aewallin/ADA4898_LNA/noise_calc/README.md

# ADA4898 LNA Noise

Low Noise Amplifier based on [ADA4898](https://www.analog.com/en/products/ada4898-1.html).
Inspired by Gerhard Hoffmann's "lono" design  http://www.hoffmann-hochfrequenz.de/downloads/lono.pdf

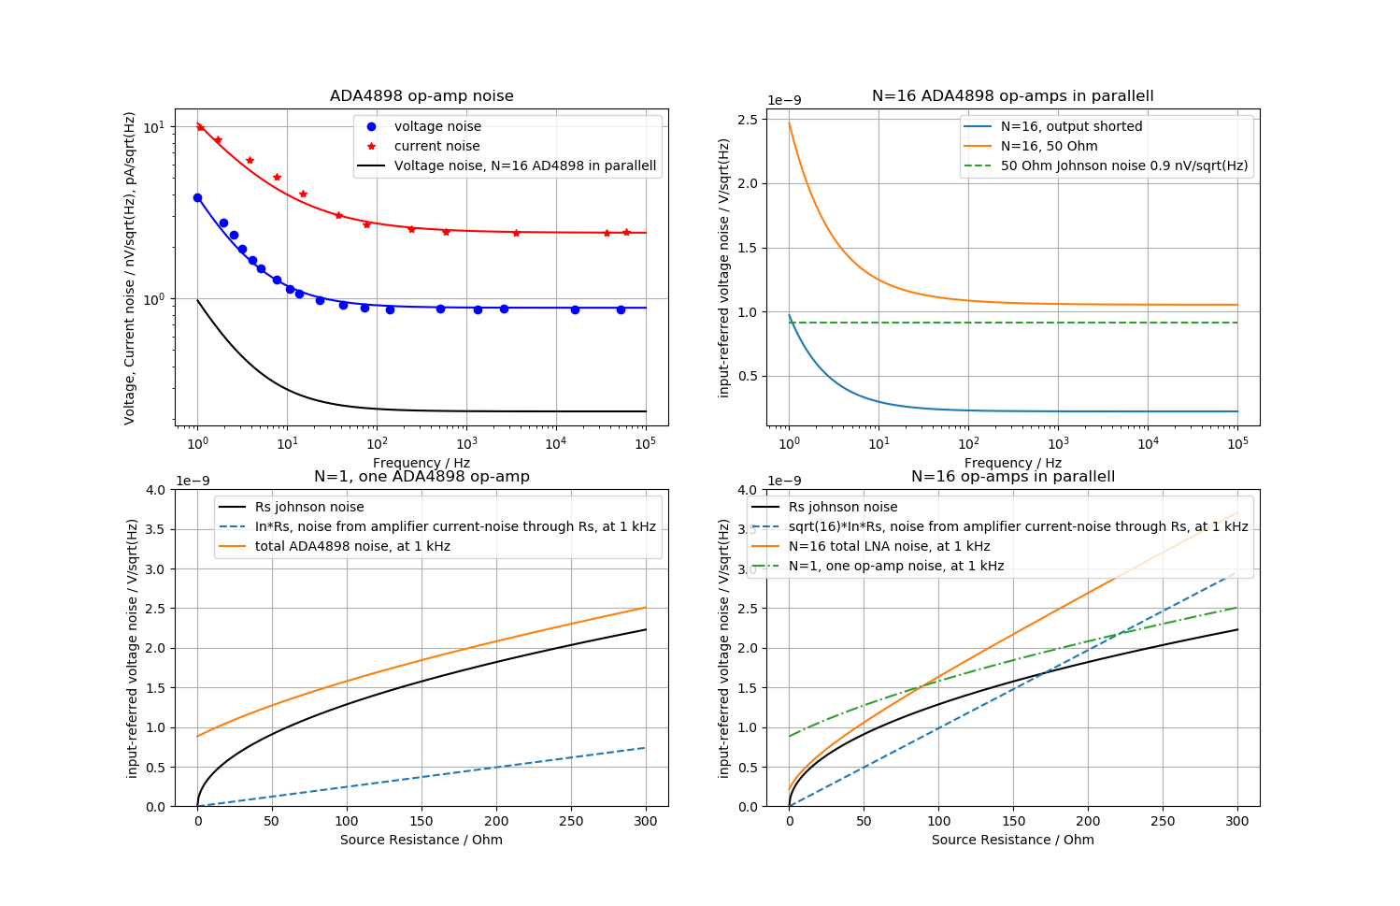
[picture p3: noise_calc/ADA4898_noise.png]
Noise noise
