aewallin/ADA4898_LNA/doc/ADA4898_LNA_schematic.pdf

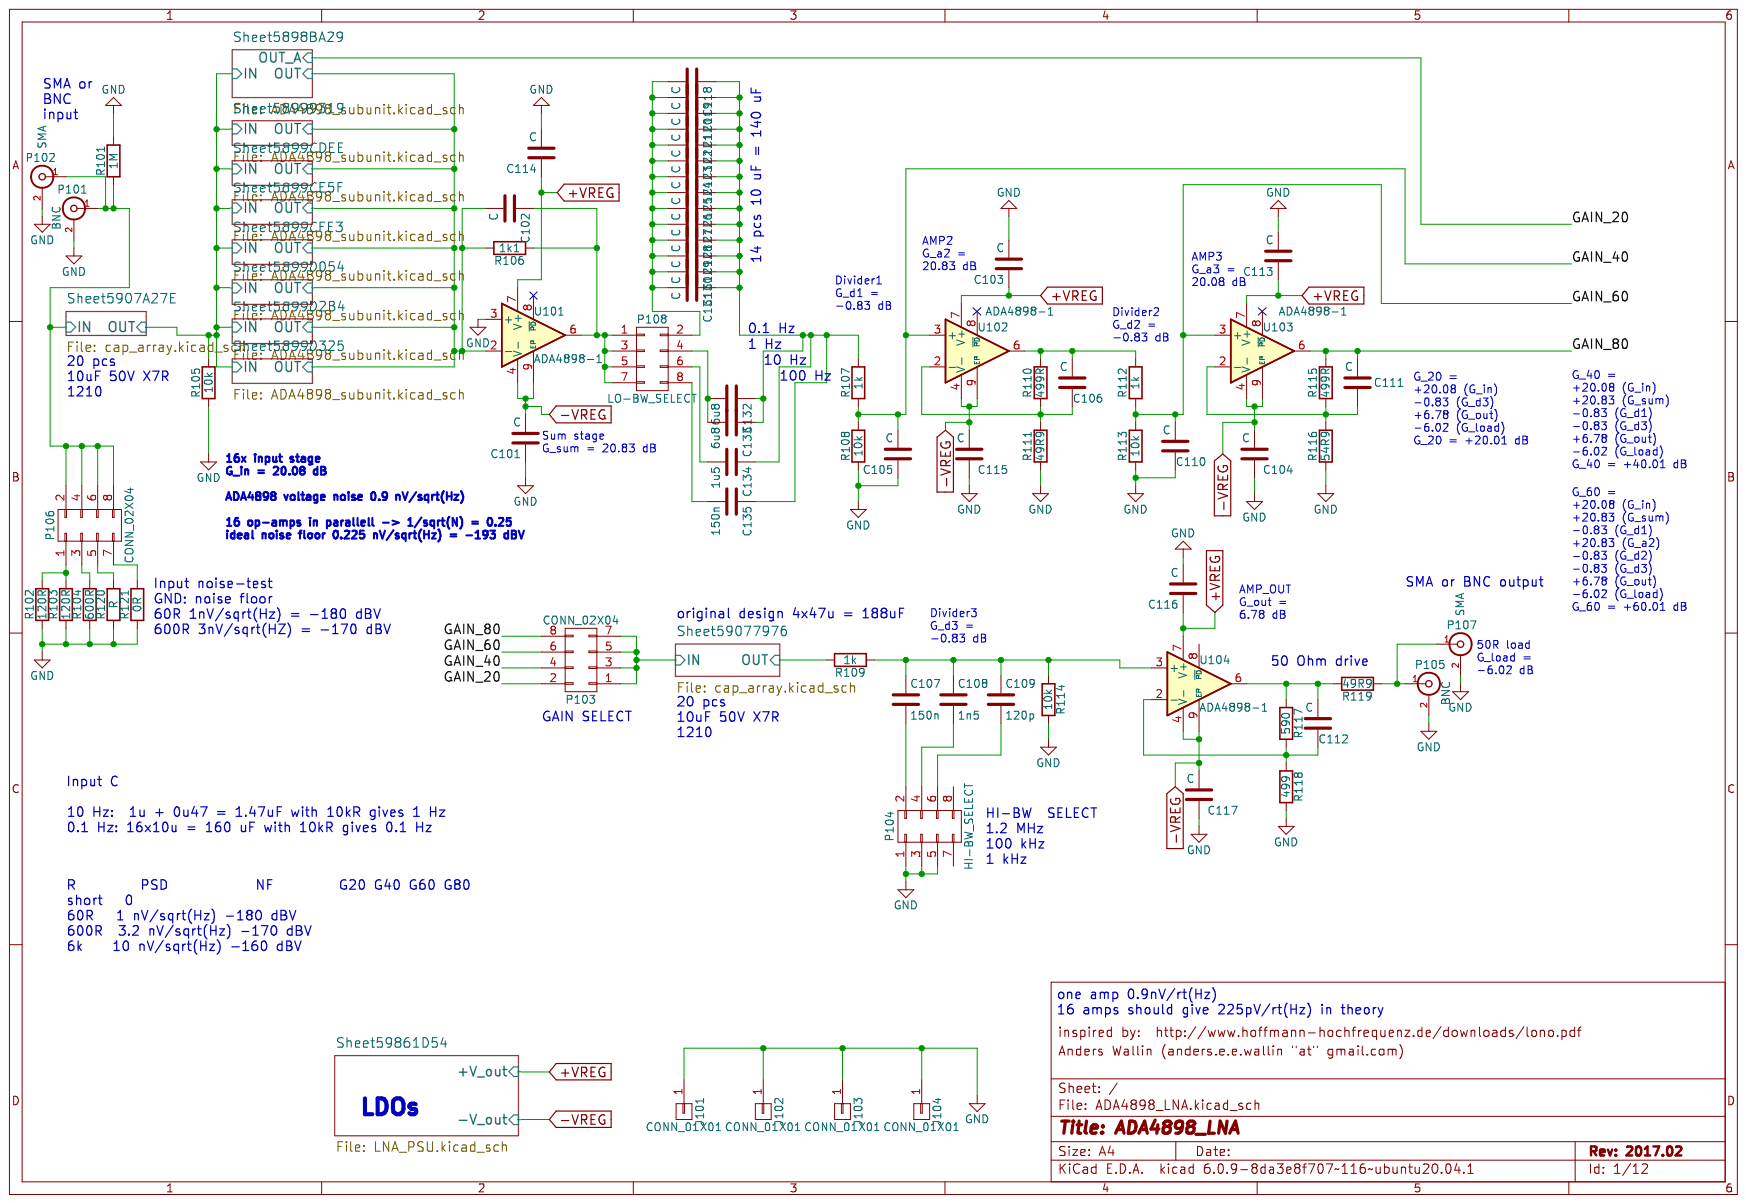
[picture p4: page 1]

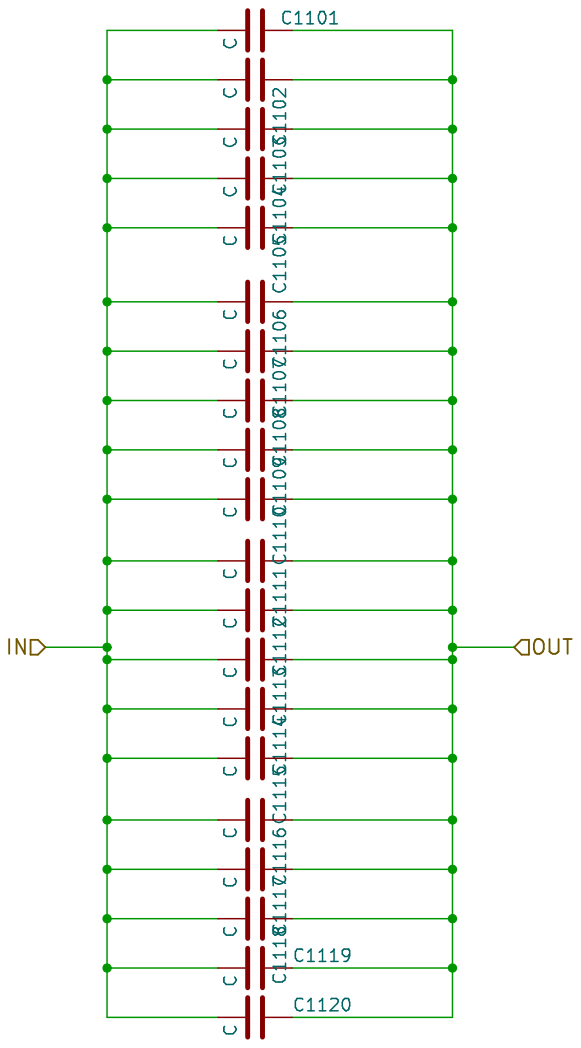
[picture p5: page 2]

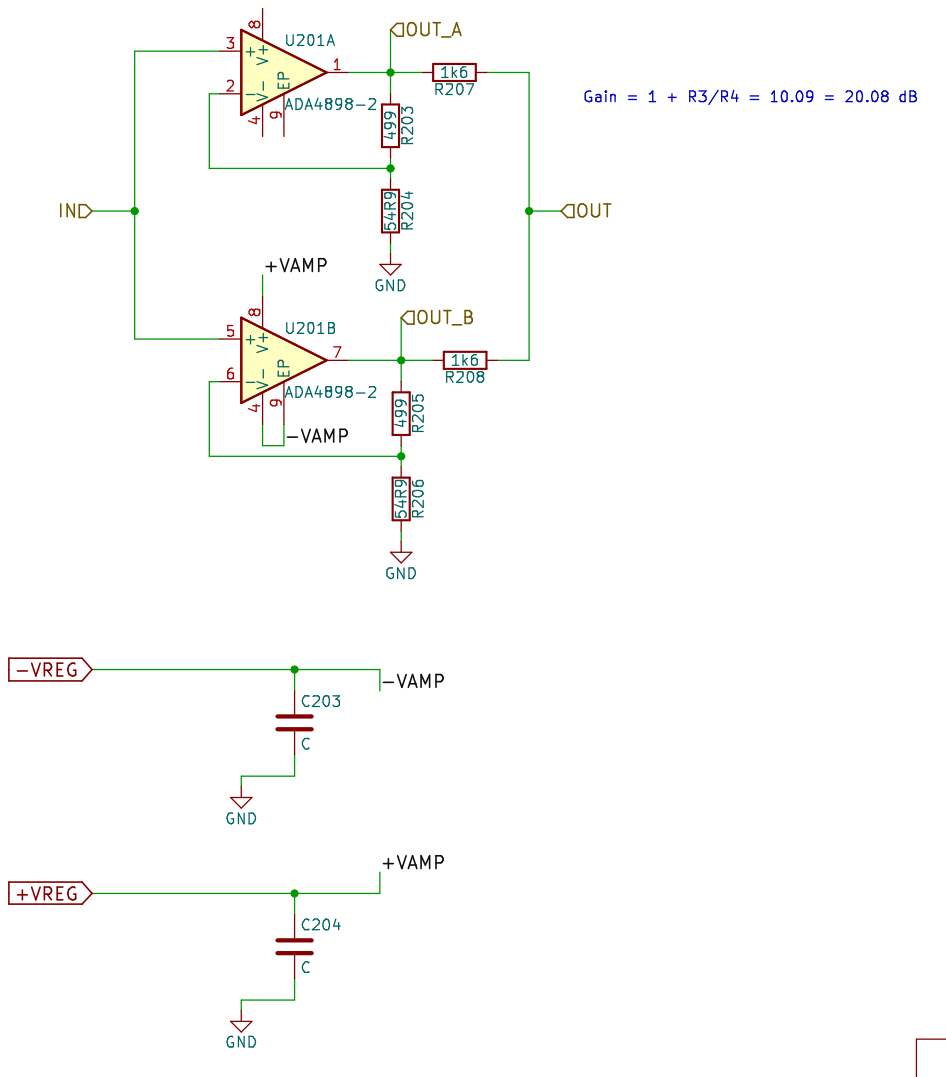
[picture p6: page 3]

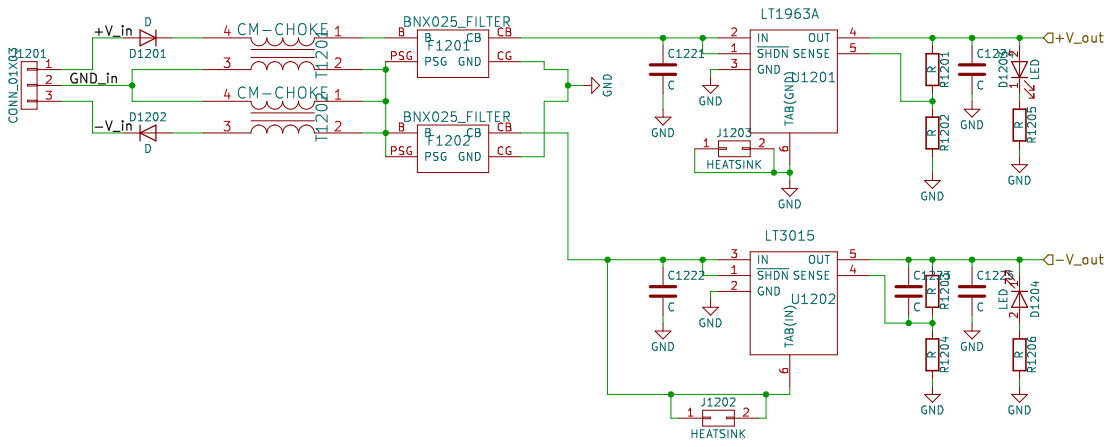
[picture p7: page 11]

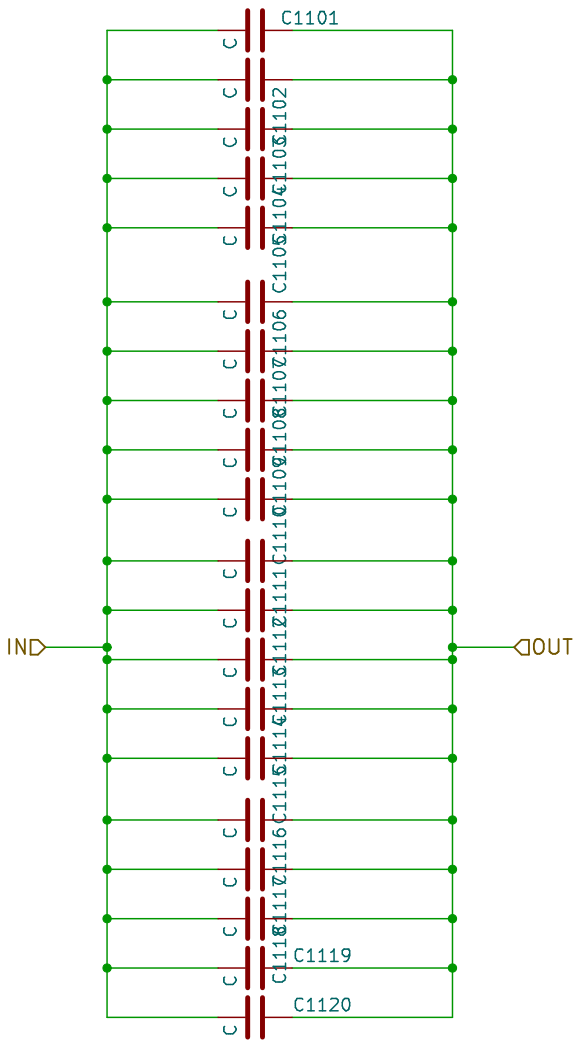
[picture p8: page 12]
