aewallin/ADA4898_LNA/doc/ADA4898_LNA_pcb.pdf

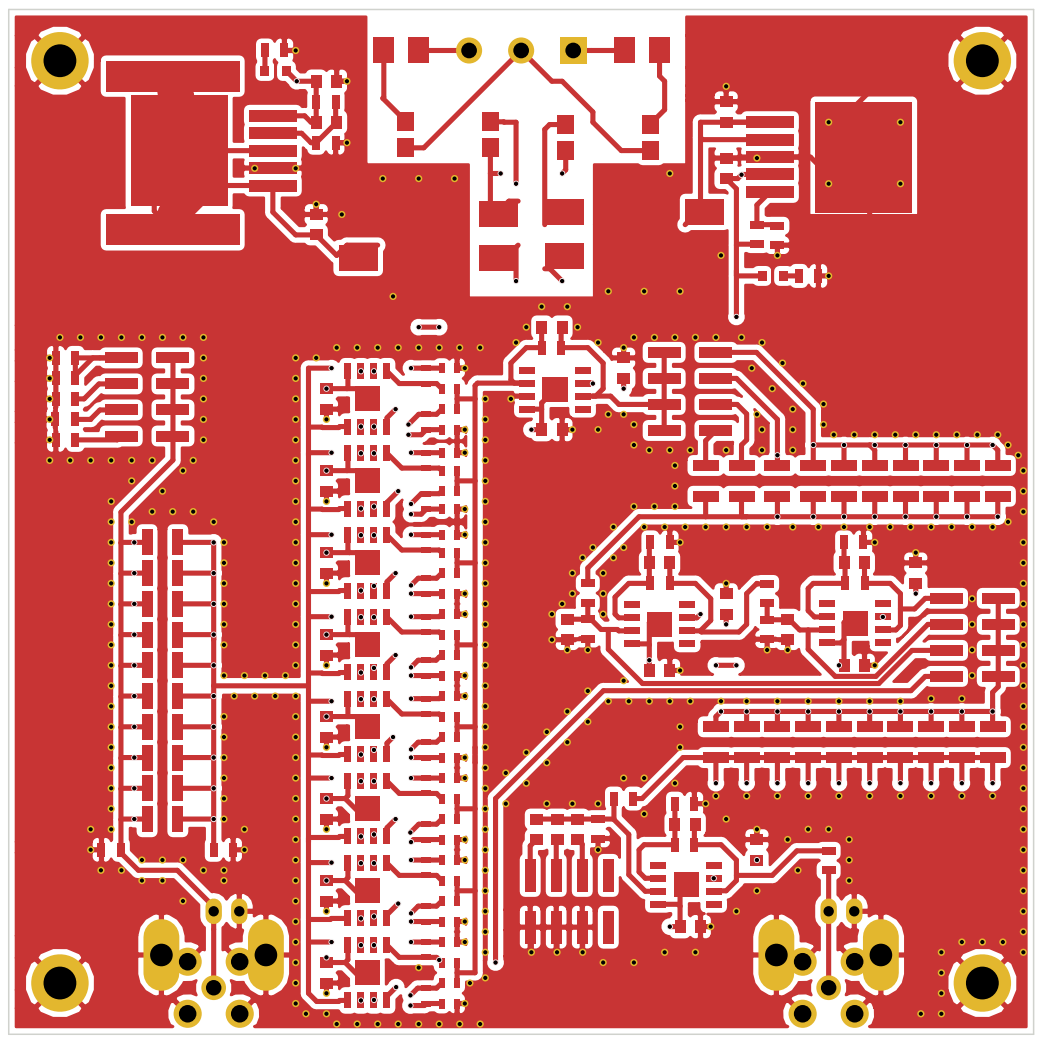
[picture p9: page 1]

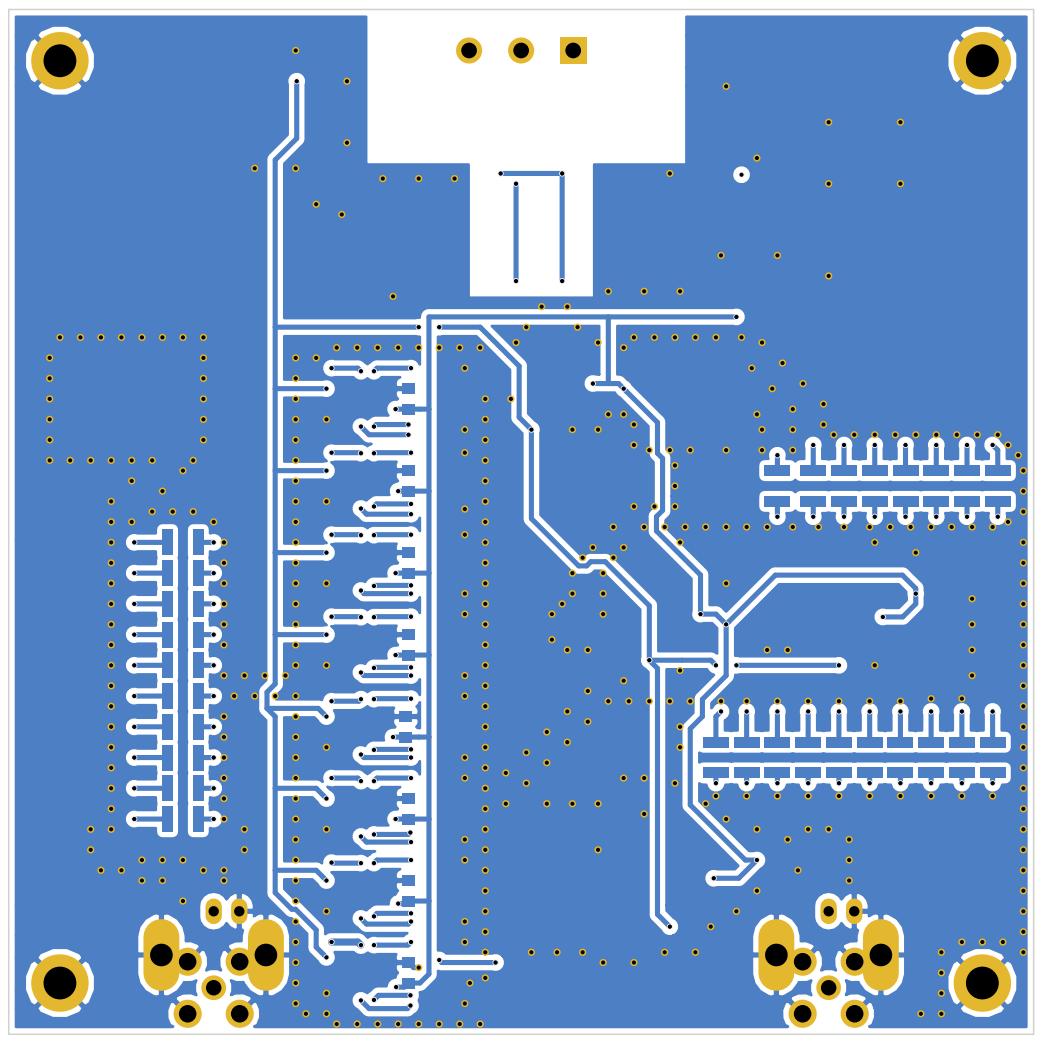
[picture p10: page 2]

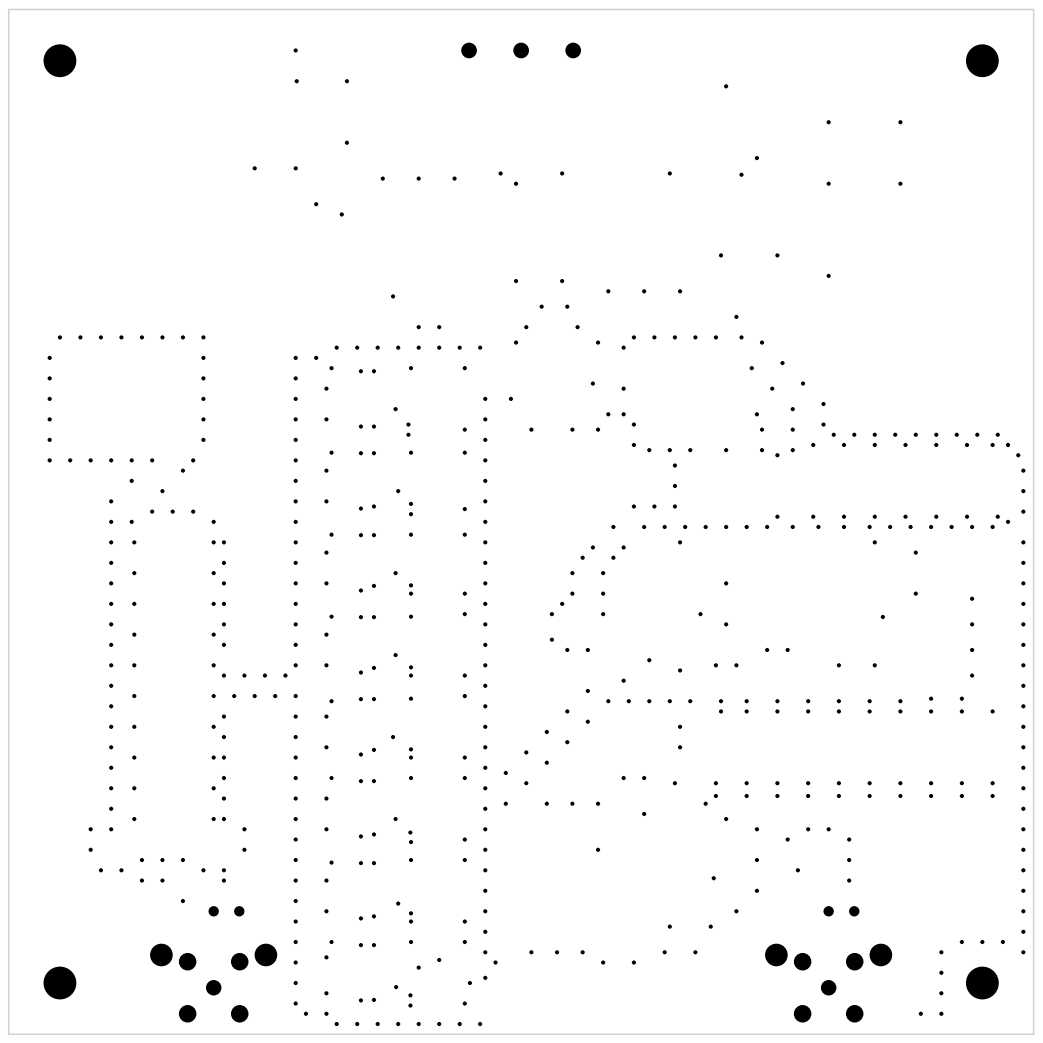
[picture p11: page 3]

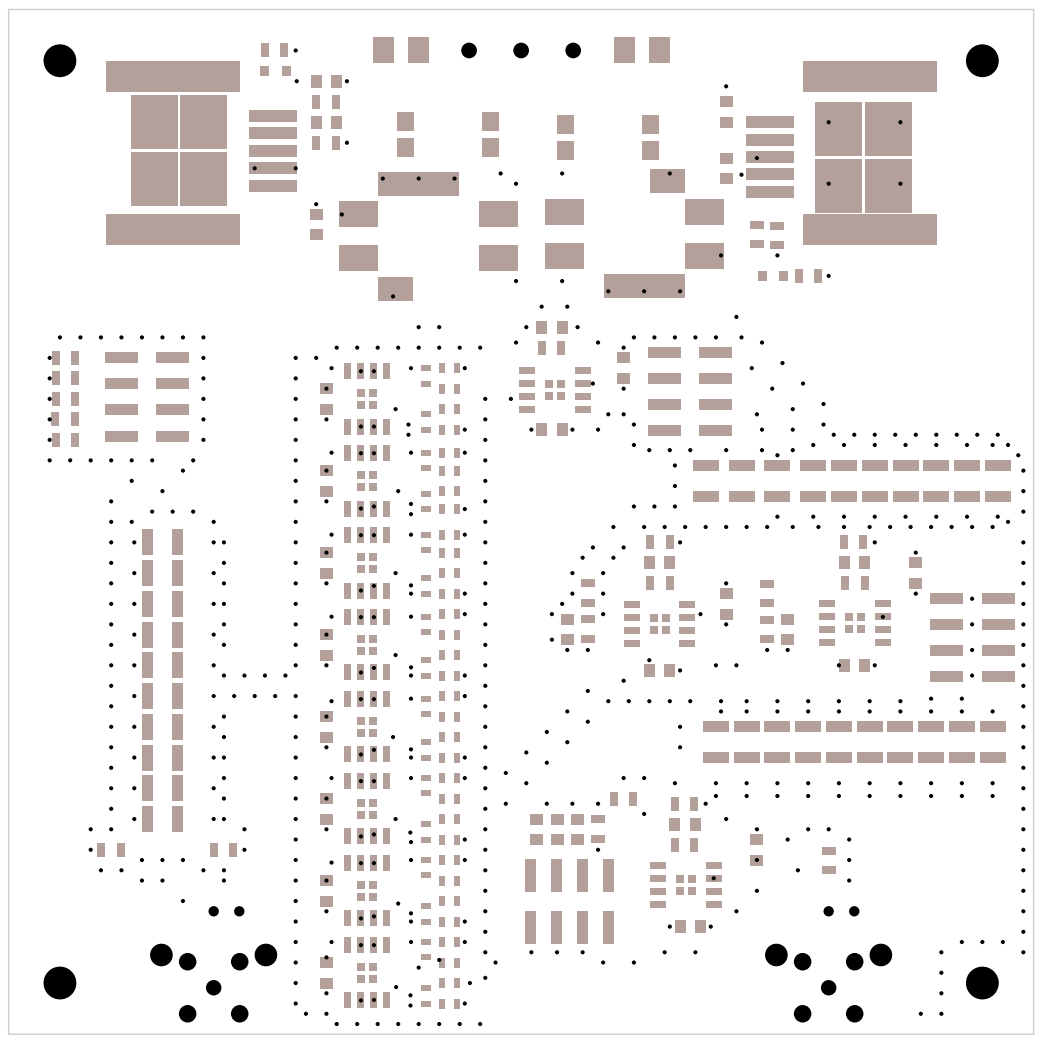
[picture p12: page 5]

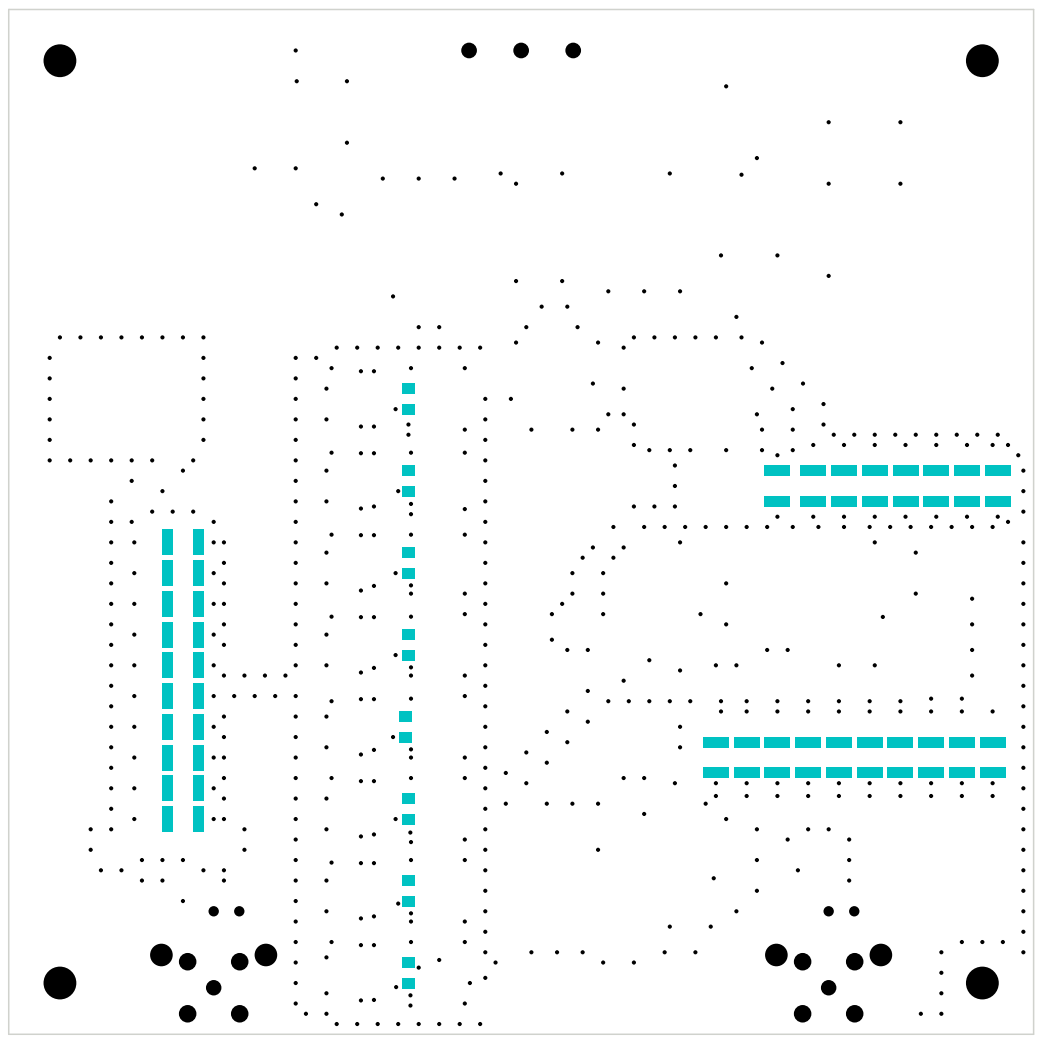
[picture p13: page 6]

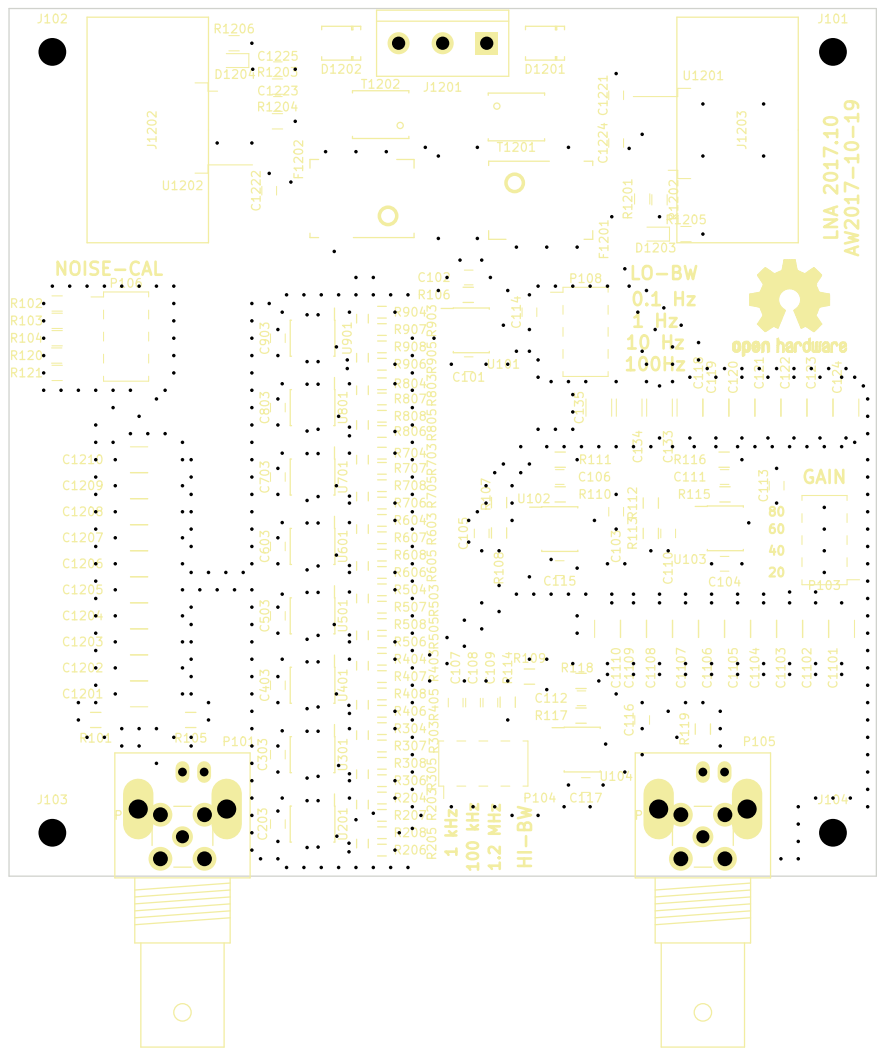
[picture p14: page 7]

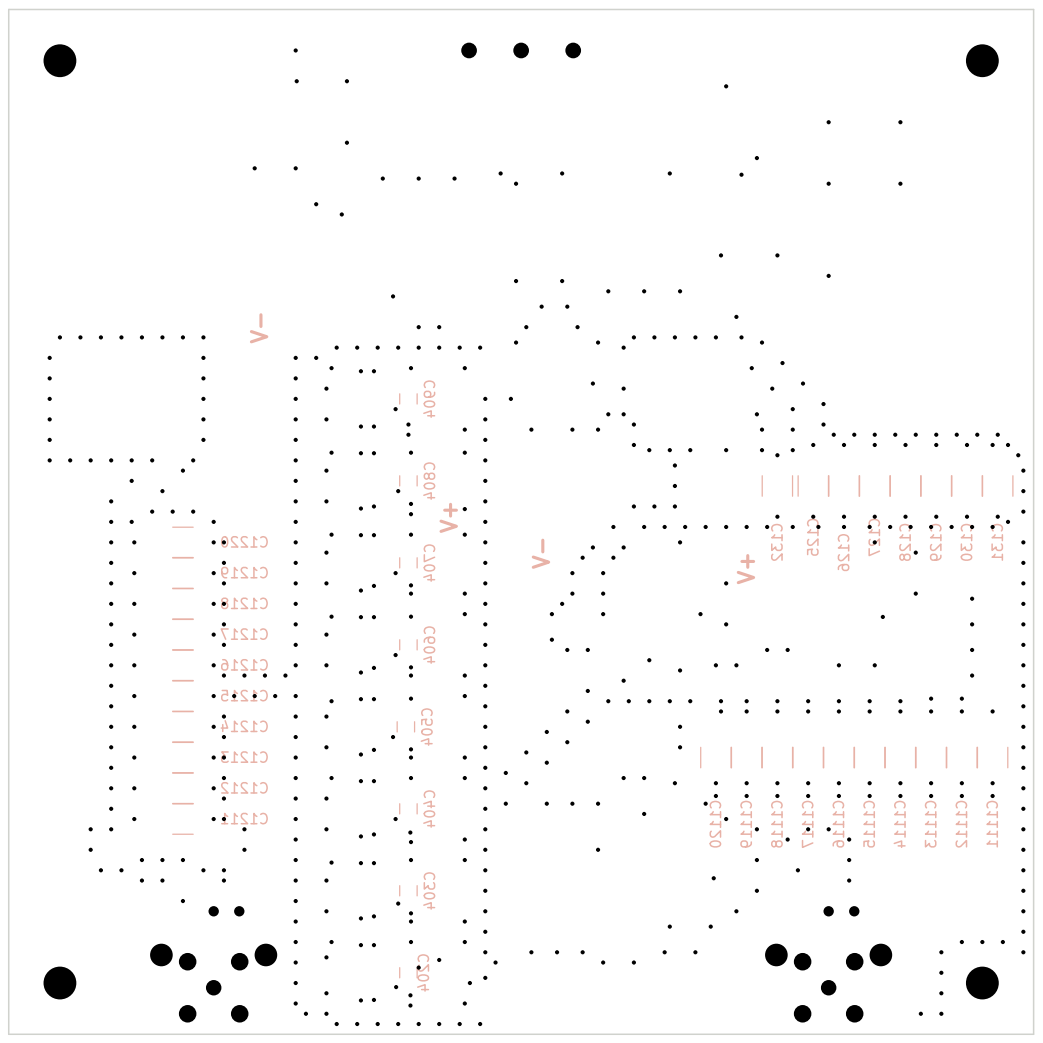
[picture p15: page 8]

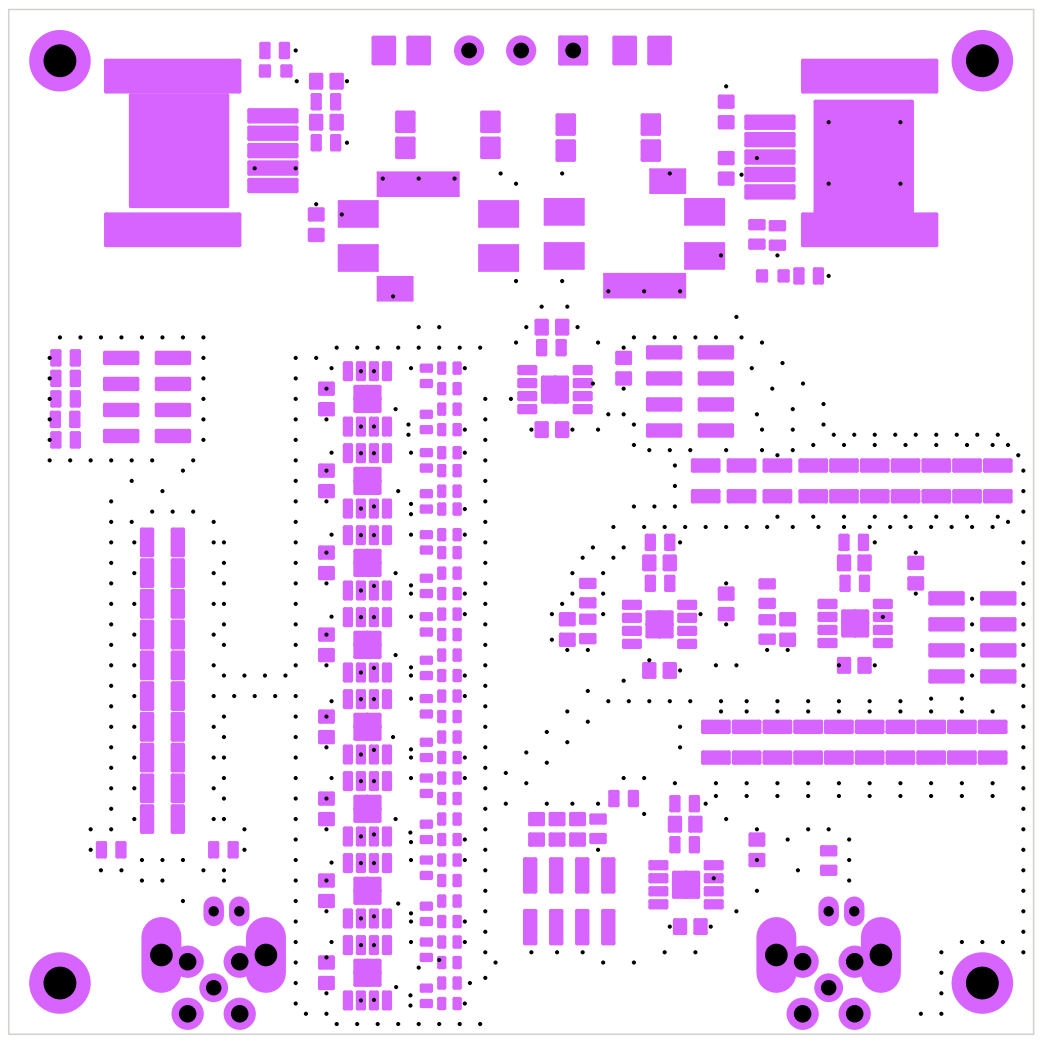
[picture p16: page 9]

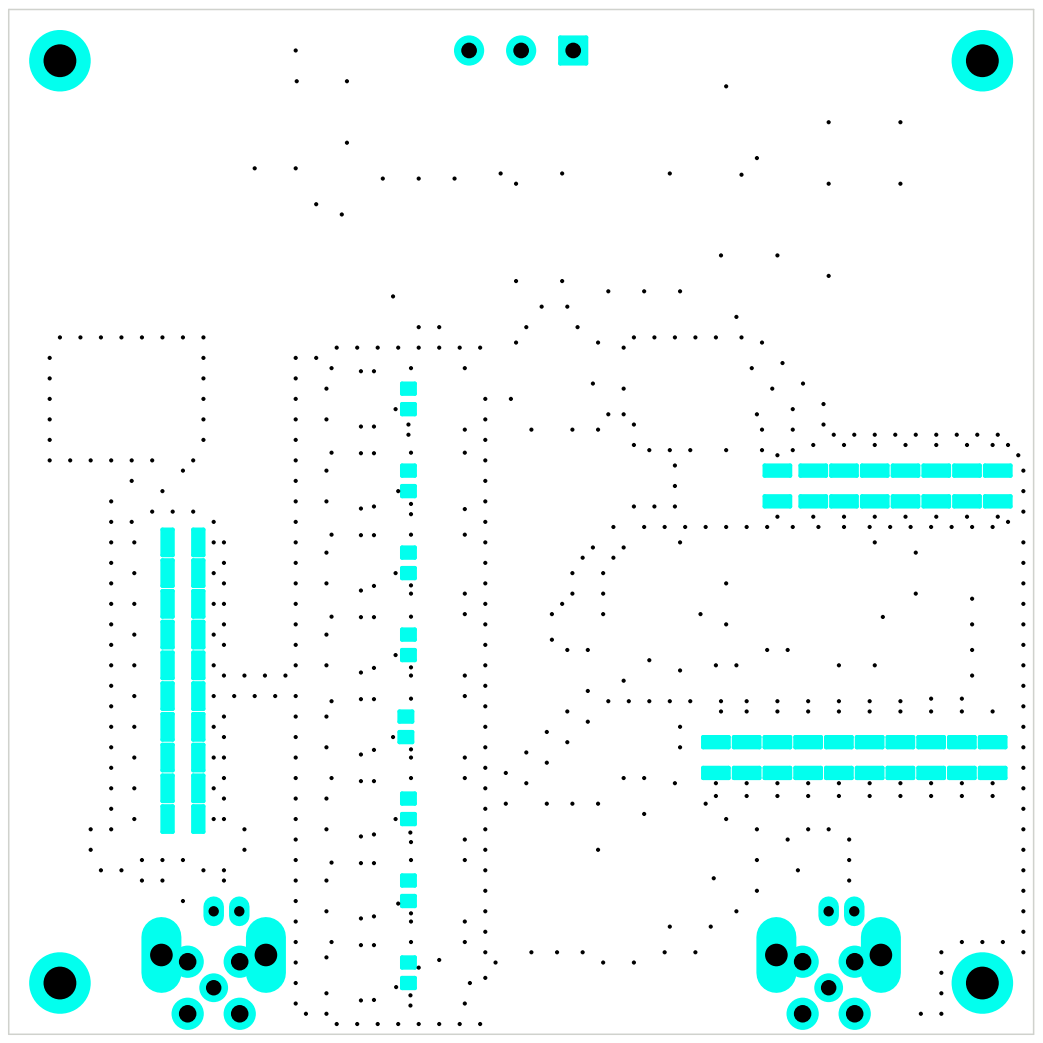
[picture p17: page 10]

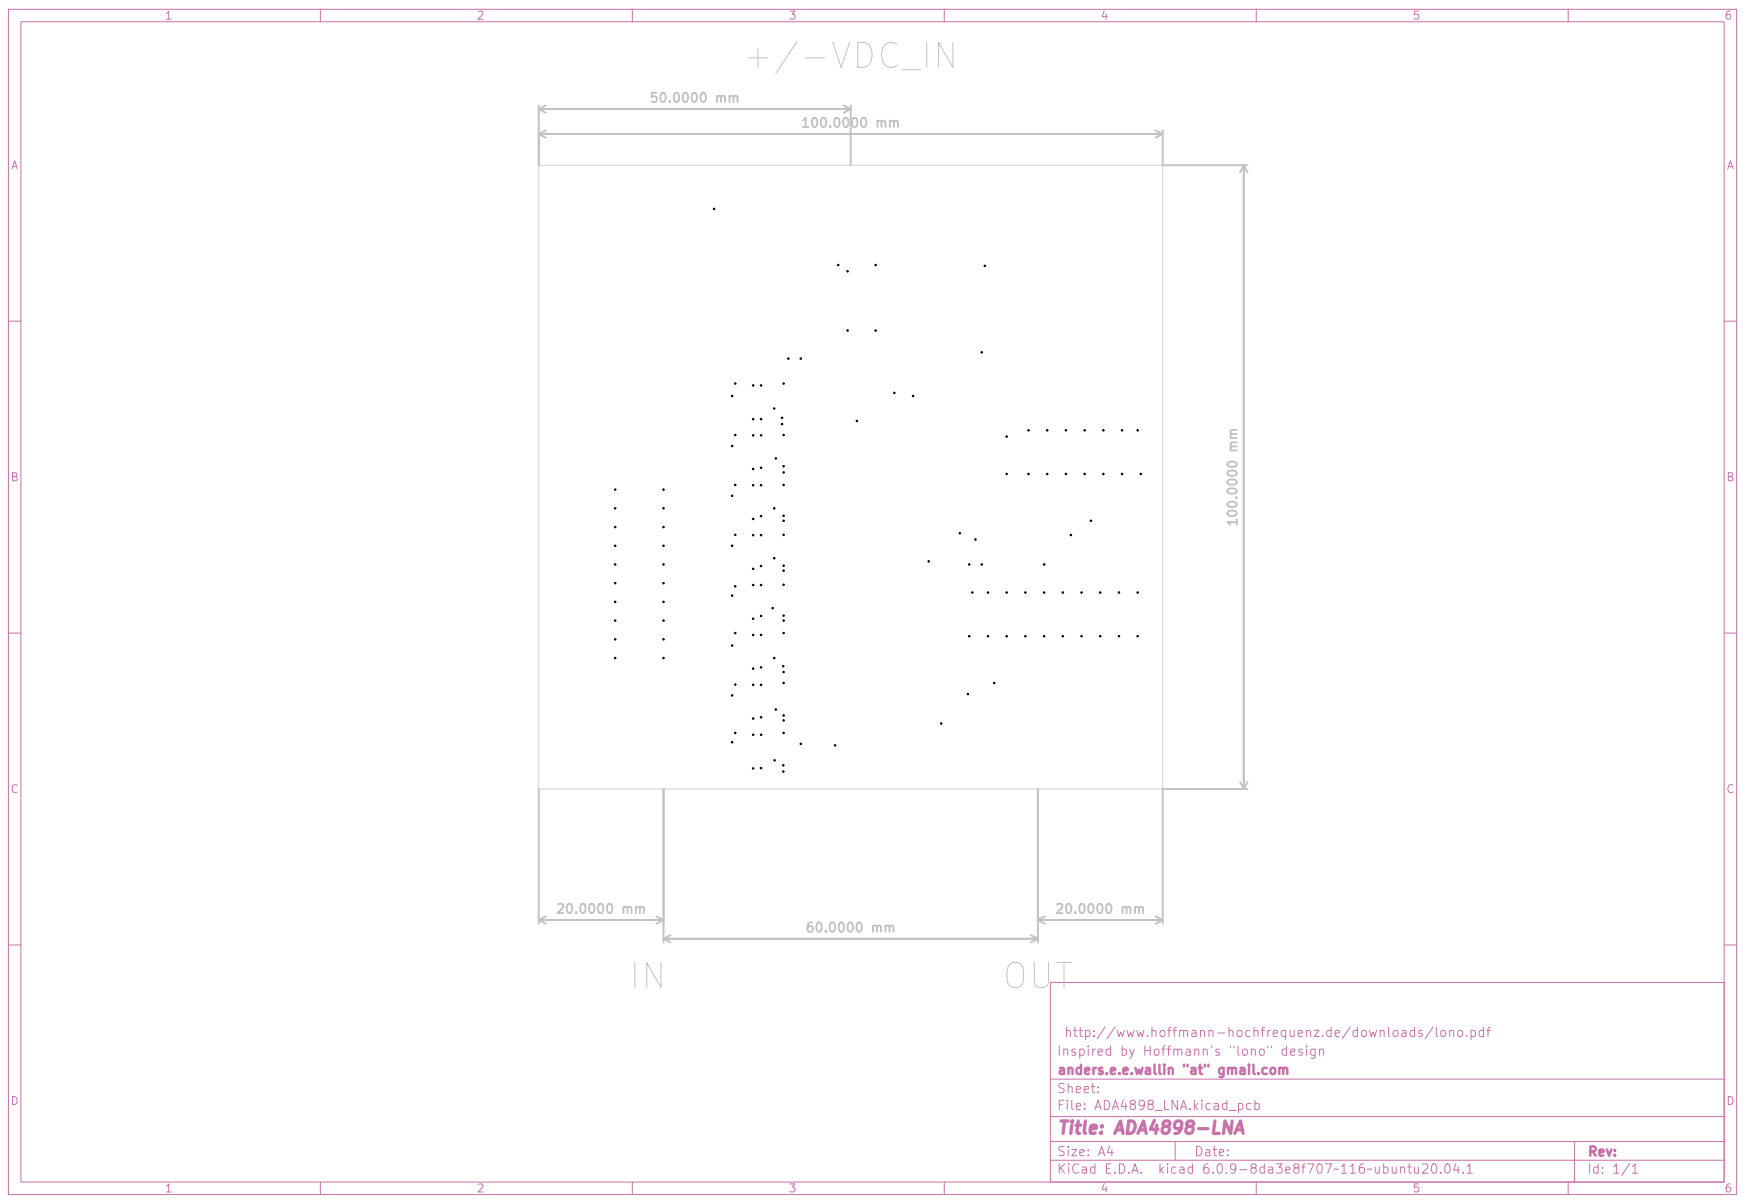
[picture p18: page 11]

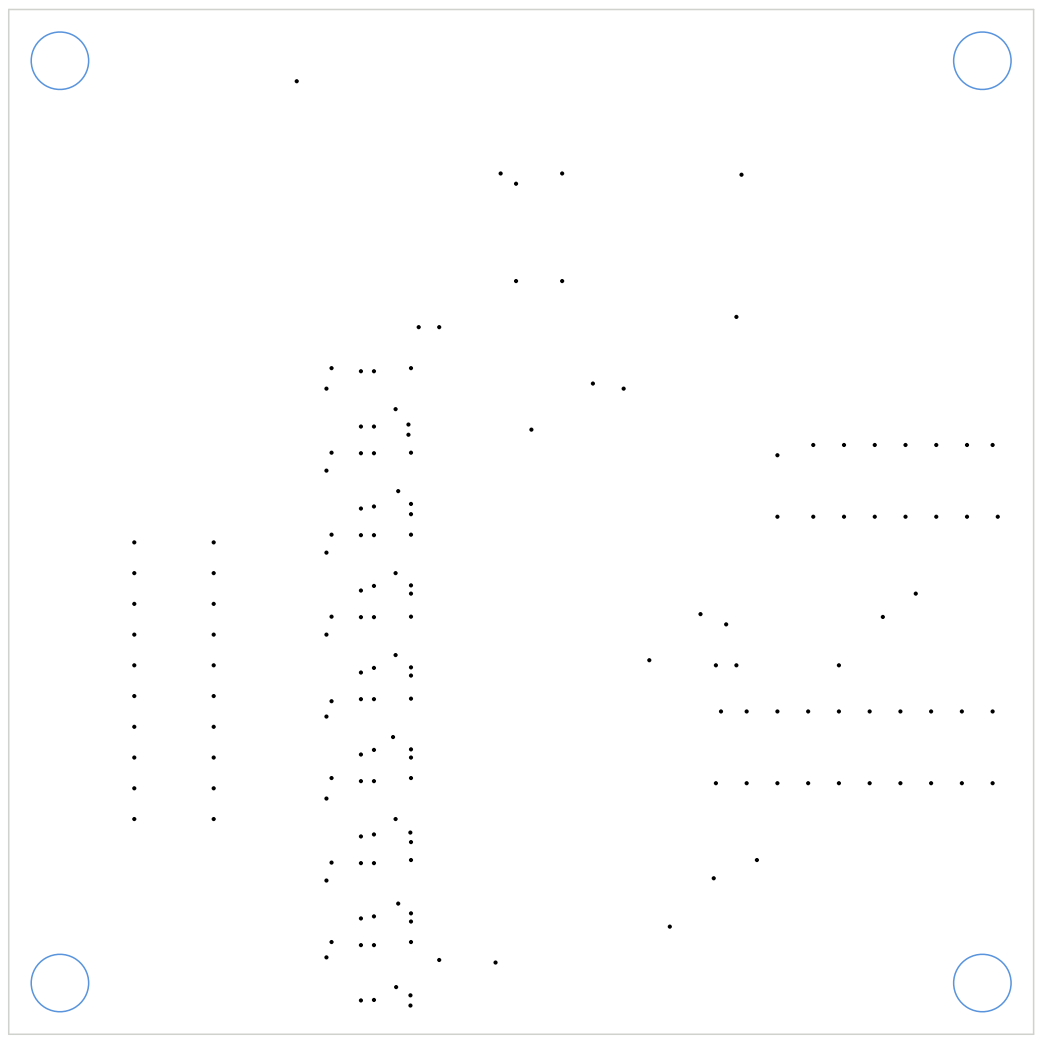
[picture p19: page 12]

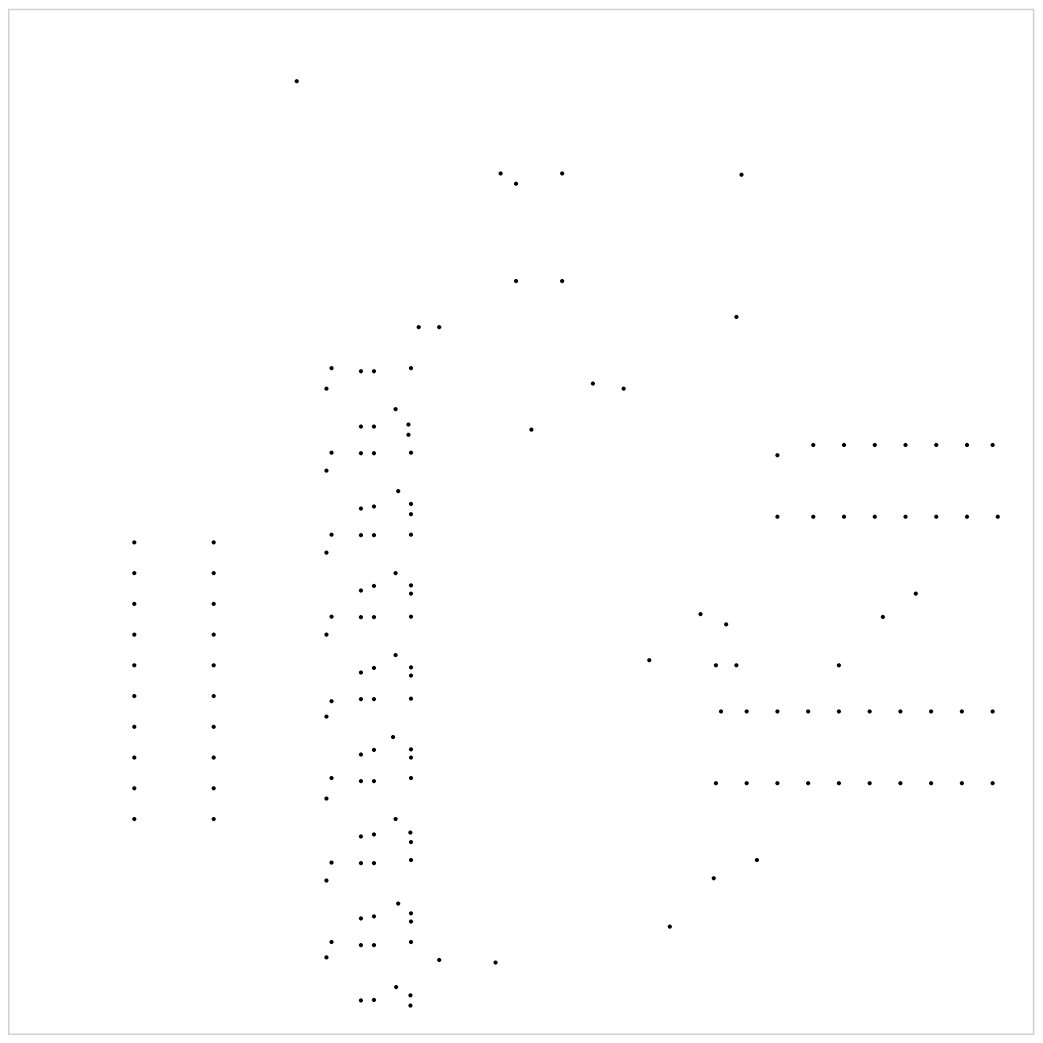
[picture p20: page 13]

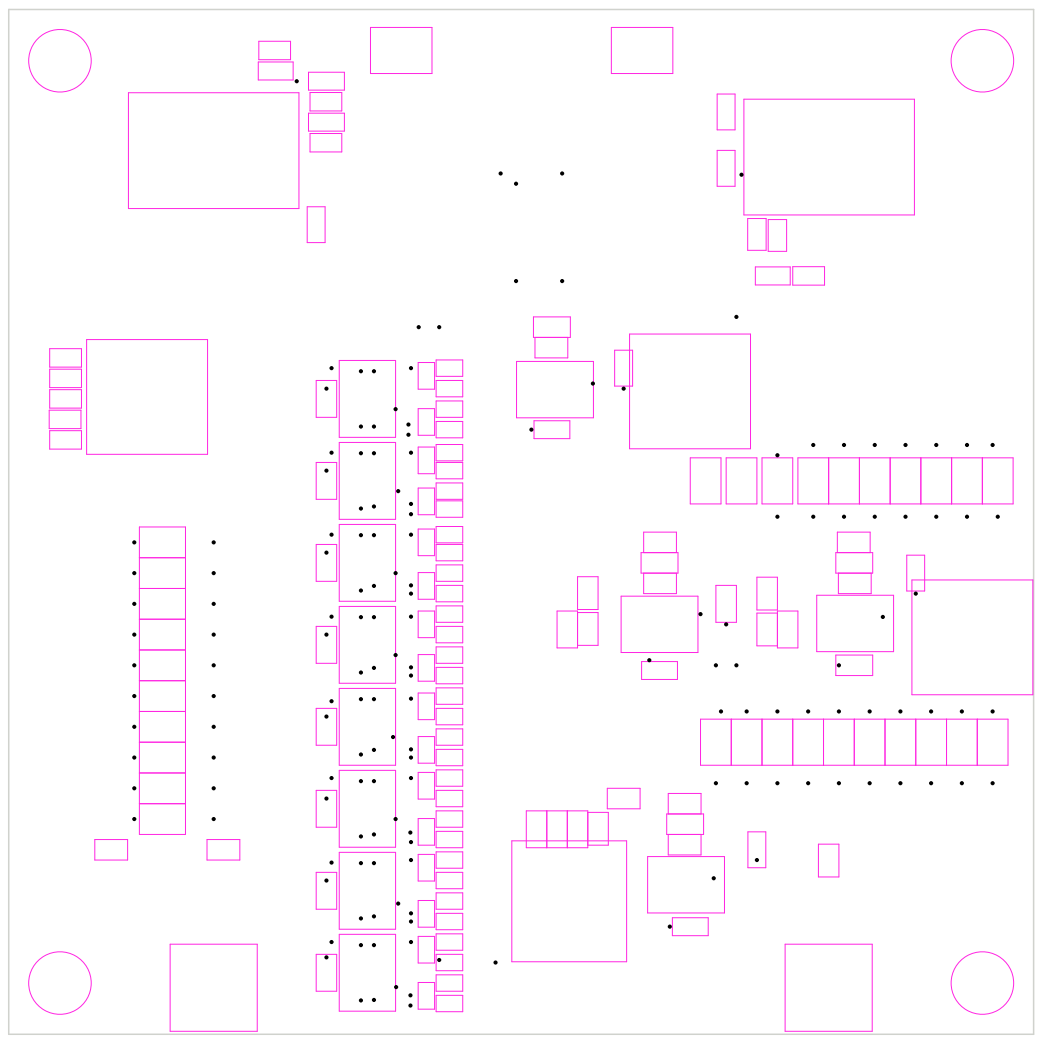
[picture p21: page 17]

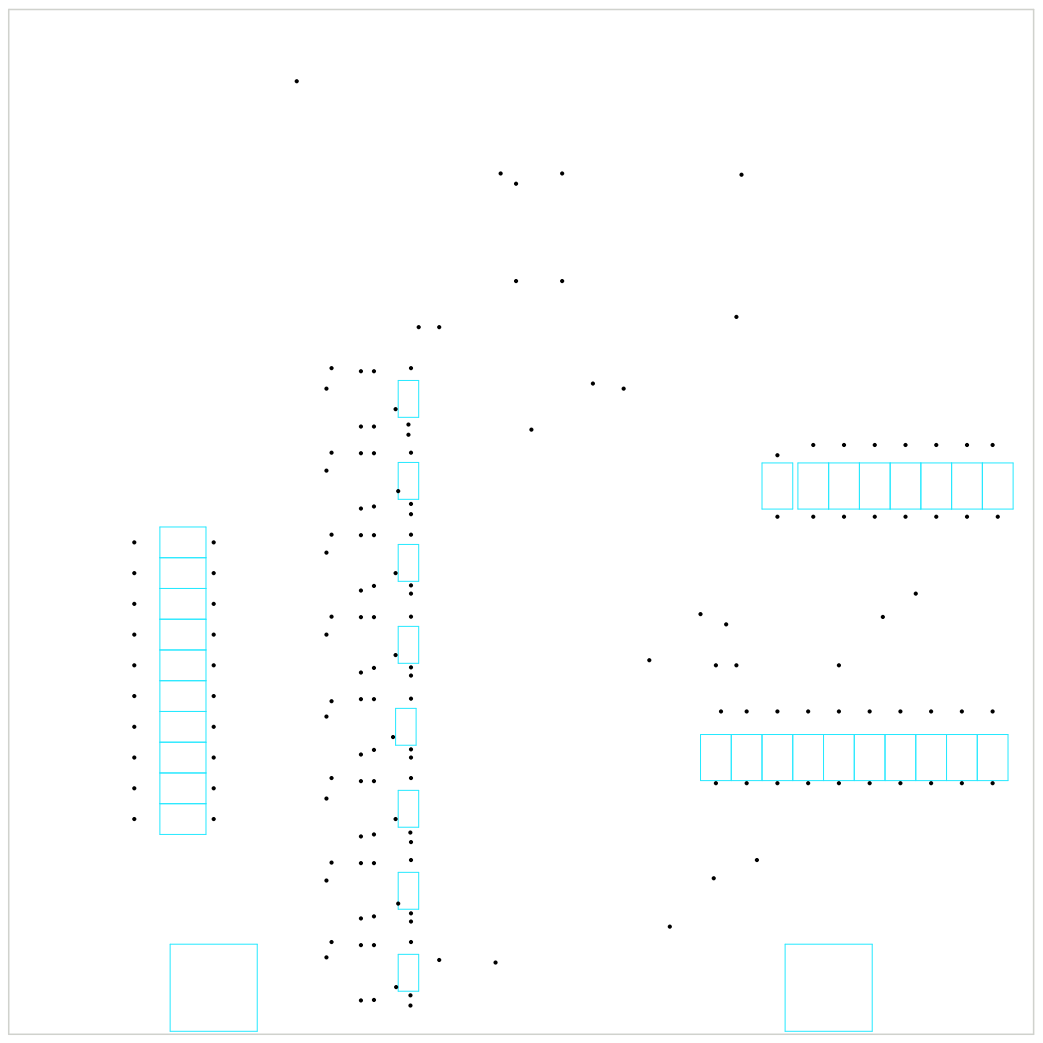
[picture p22: page 18]

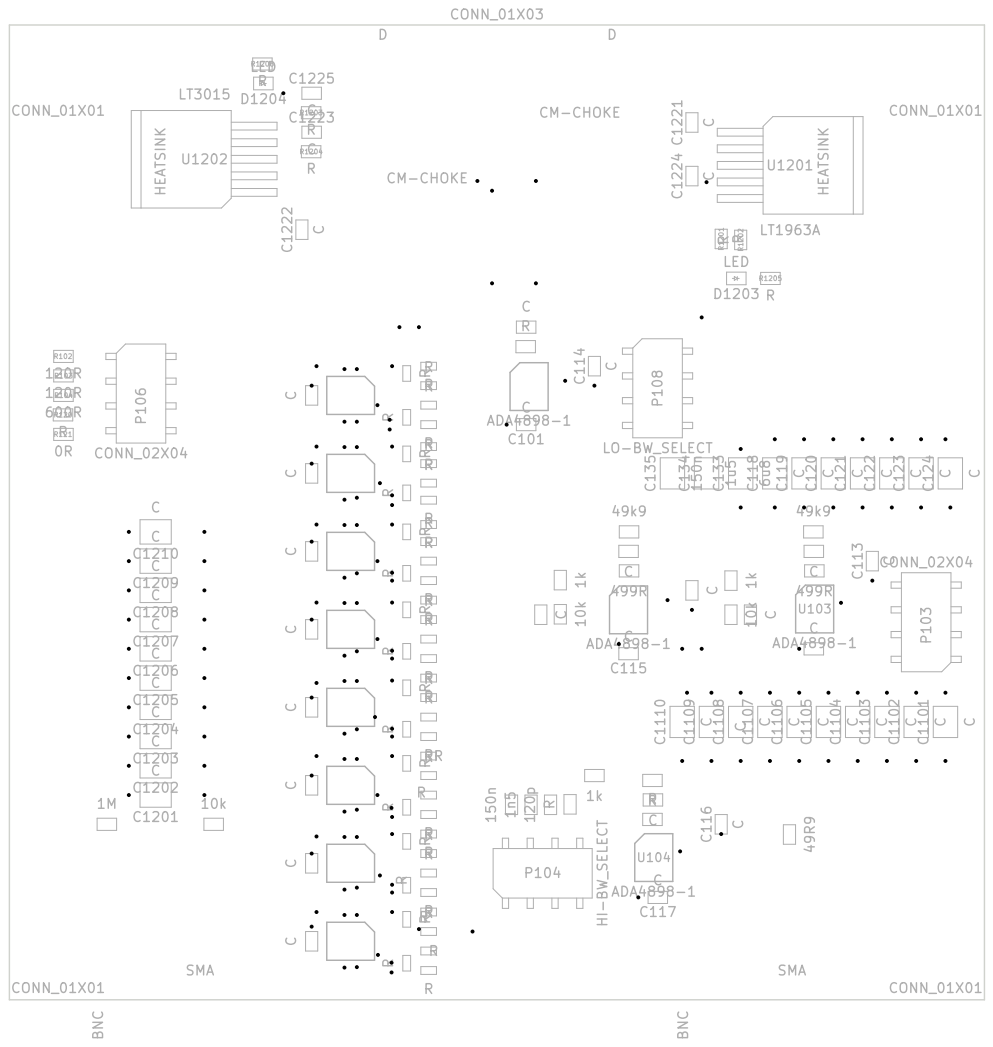
[picture p23: page 19]

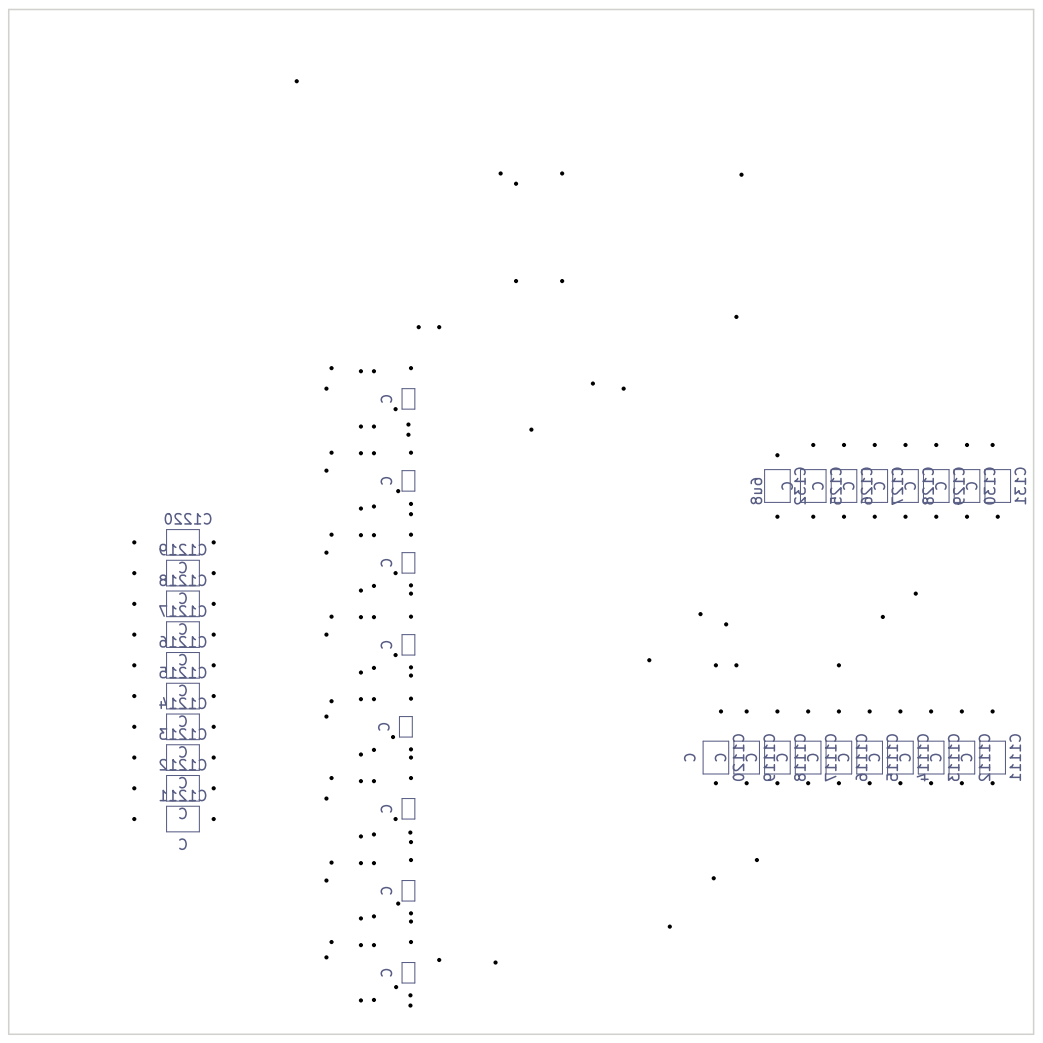
[picture p24: page 20]
