aewallin/ADA4898_LNA/doc/ADA4898_LNA_pcb_onepage.pdf

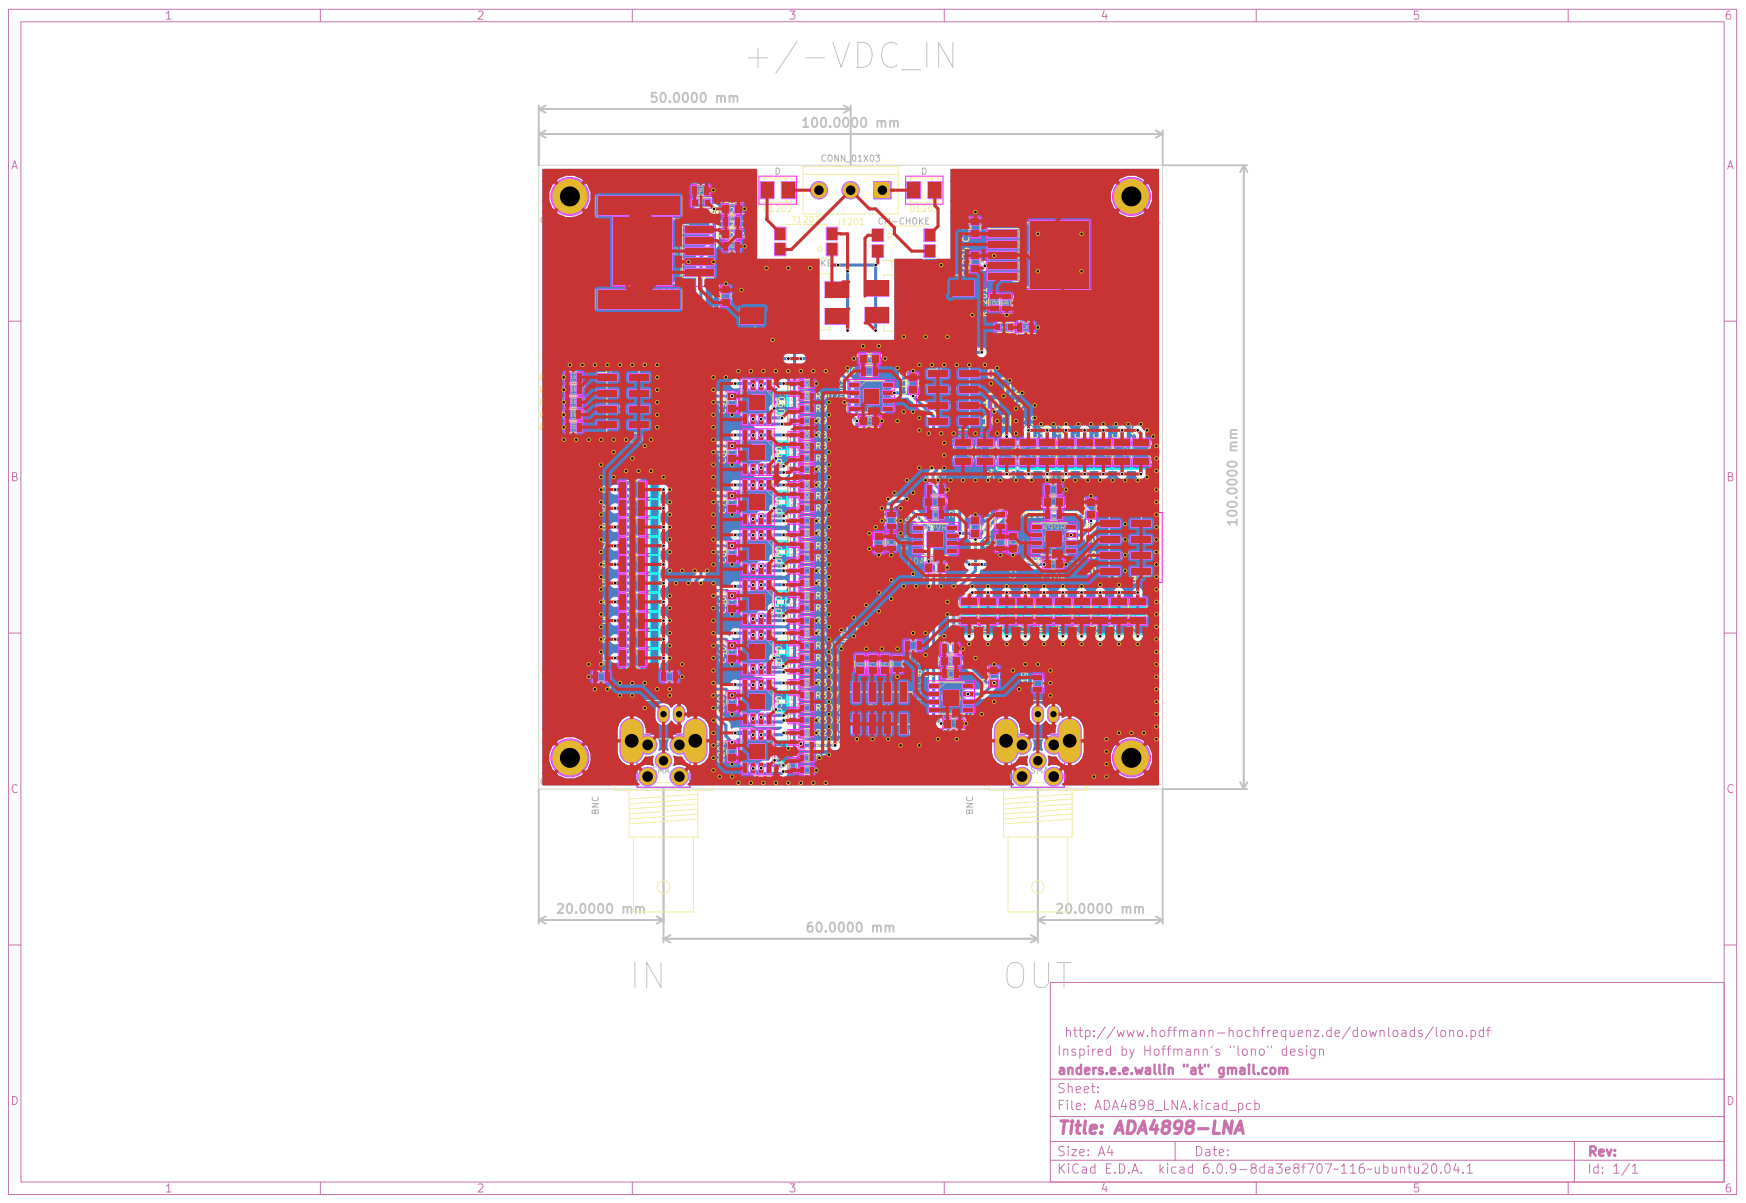
[picture p25: page 1]
