aewallin/ADA4898_LNA/ADA4898_LNA.kicad_sch

## KiCad design ADA4898_LNA.kicad_sch (2025-11-16)

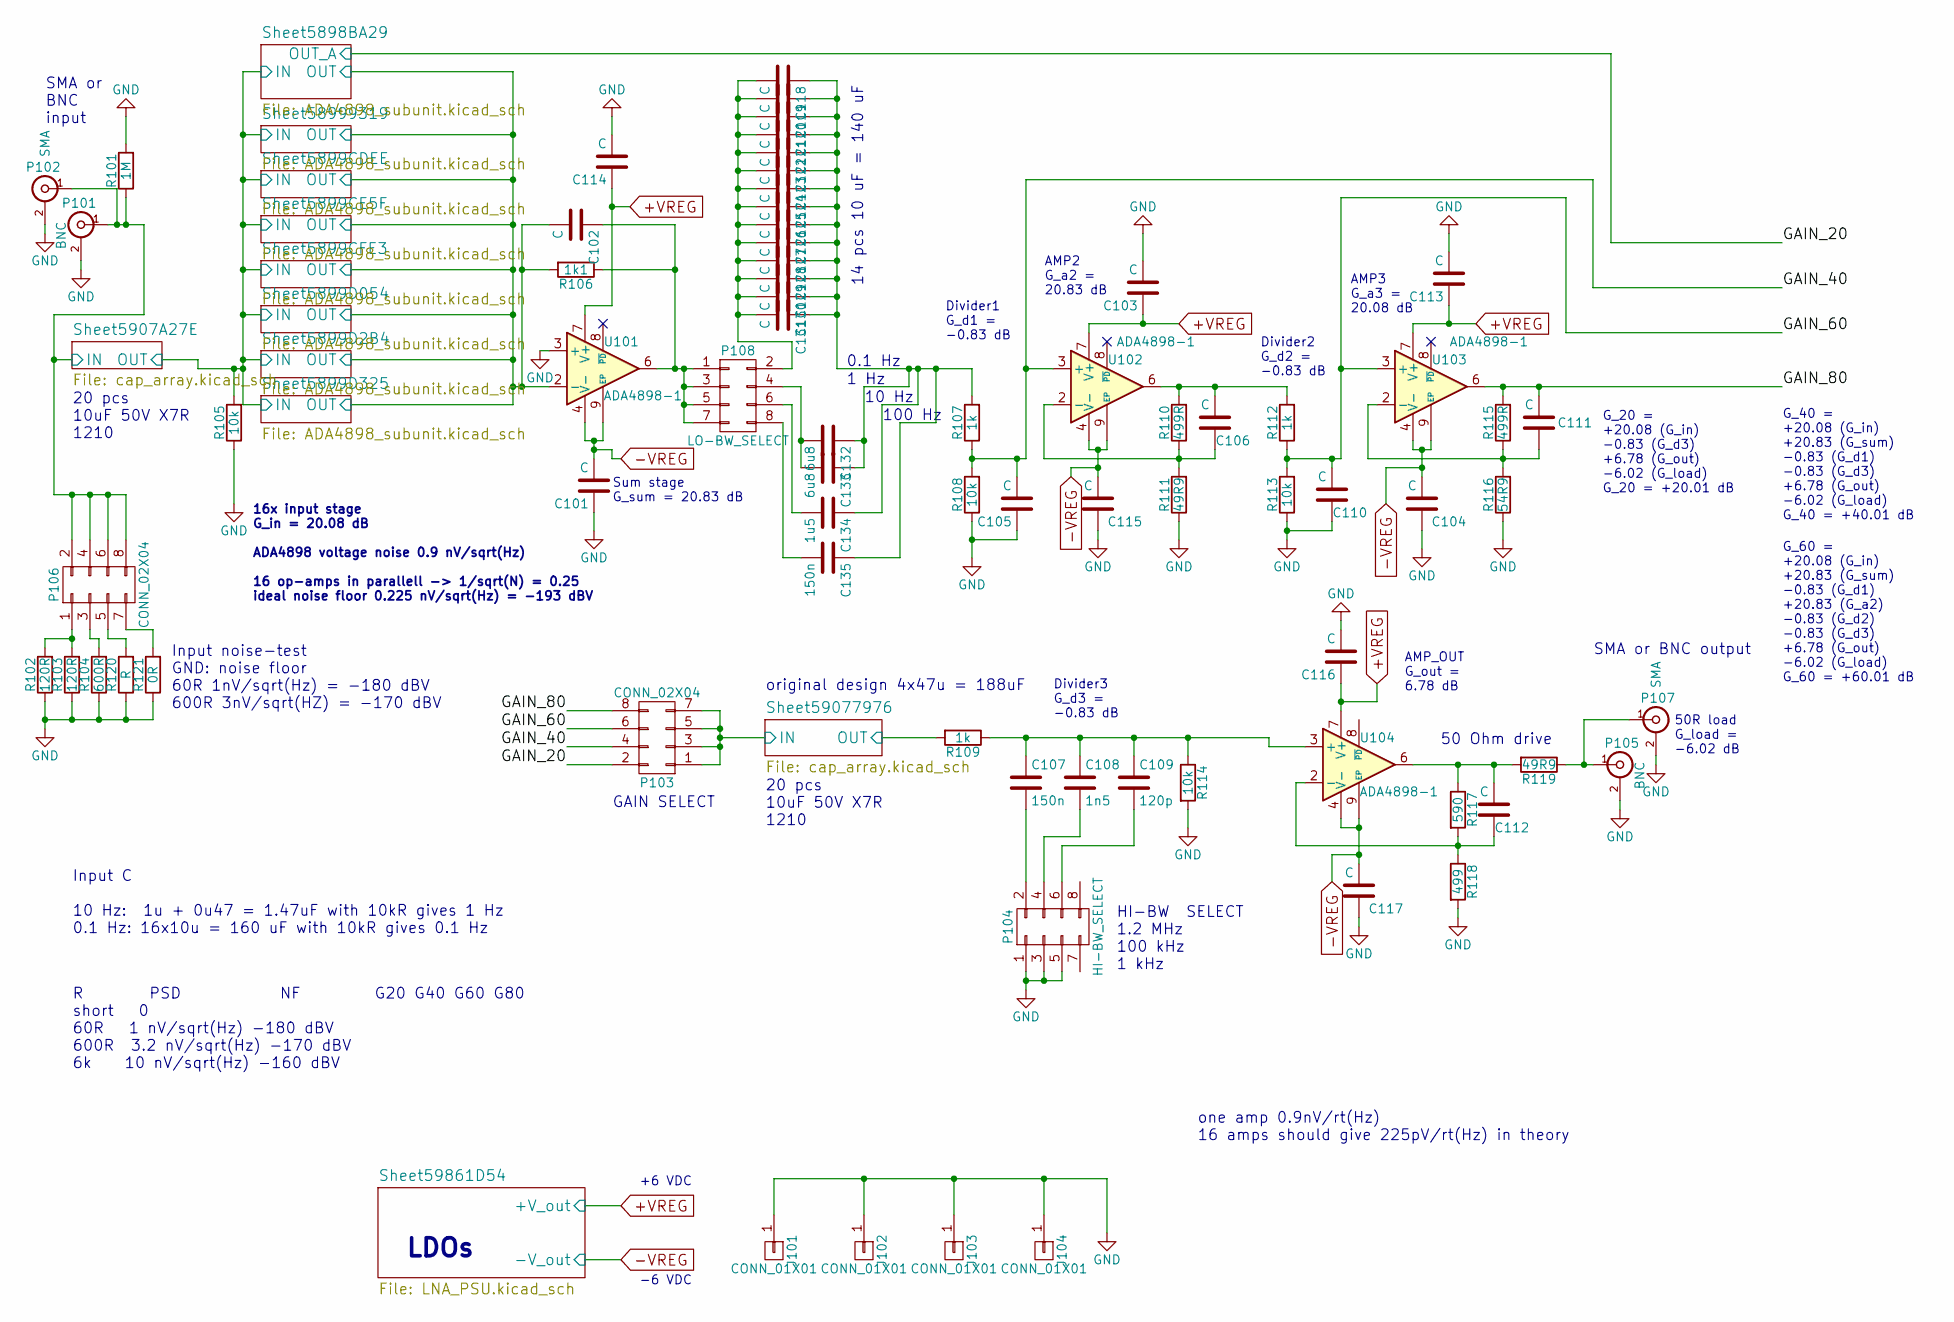
[picture p26: schematic ADA4898_LNA.kicad_sch]

Parts:
C101, C102, C103, C104, C105, C106, C110, C111, C112, C113, C114, C115, C116, C117: C; C_0805
C107: 150n; C_0805
C108: 1n5; C_0805
C109: 120p; C_0805
C118, C119, C120, C121, C122, C123, C124, C125, C126, C127, C128, C129, C130, C131: C; C_1210
C132, C133: 6u8; C_1210
C134: 1u5; C_1210
C135: 150n; C_1210
J101, J102, J103, J104: CONN_01X01; MountingHole_3.2mm_M3_DIN965_Pad
P101, P105: BNC; BNC_2PIN
P102, P107: SMA; CONNECTOR_SMA_Straight
P103, P106: CONN_02X04; Pin_Header_Straight_2x04_Pitch2.54mm_SMD
P104: HI-BW_SELECT; Pin_Header_Straight_2x04_Pitch2.54mm_SMD
P108: LO-BW_SELECT; Pin_Header_Straight_2x04_Pitch2.54mm_SMD
R101: 1M; R_0805
R102, R103: 120R; R_0805
R104: 600R; R_0805
R105, R108, R113, R114: 10k; R_0805
R106: 1k1; R_0805
R107, R109, R112: 1k; R_0805
R110, R115: 499R; R_0805
R111, R119: 49R9; R_0805
R116: 54R9; R_0805
R117: 590; R_0805
R118: 499; R_0805
R120: R; R_0805
R121: 0R; R_0805
U101, U102, U103, U104: ADA4898-1; SOIC-8-1EP_3.9x4.9mm_Pitch1.27mm

Connections:
+VREG: C103.1, C113.1, C114.1, C116.1, U101.7 (V+), U102.7 (V+), U103.7 (V+), U104.7 (V+)
-VREG: C101.2, C104.2, C115.2, C117.2, U101.4 (V-), U101.9 (EP), U102.4 (V-), U102.9 (EP), U103.4 (V-), U103.9 (EP), U104.4 (V-), U104.9 (EP)
GAIN_20: P103.2
GAIN_40: C105.2, P103.4, R107.1, R108.2, U102.3 (+)
GAIN_60: C110.2, P103.6, R112.1, R113.2, U103.3 (+)
GAIN_80: C111.2, P103.8, R115.2, U103.6
GND: C101.1, C103.2, C104.1, C105.1, C110.1, C113.2, C114.2, C115.1, C116.2, C117.1, J101.1, J102.1, J103.1, J104.1, P101.2 (Ext), P102.2 (Ext), P104.1, P104.3, P104.5, P105.2 (Ext), P107.2 (Ext), R101.2, R102.1, R103.1, R104.1, R105.1, R108.1, R111.1, R113.1, R114.2, R116.1, R118.2, R120.1, R121.1, U101.3 (+)
IN: P101.1 (In), P102.1 (In), P103.1, P103.3, P103.5, P103.7, P106.2, P106.4, P106.6, P106.8, R101.1, R105.2
unnamed: C102.1, P108.1, P108.3, P108.5, P108.7, R106.1, U101.6
unnamed: C106.1, R110.1, R111.2, U102.2 (-)
unnamed: C106.2, R110.2, R112.2, U102.6
unnamed: C107.1, C108.1, C109.1, R109.1, R114.1, U104.3 (+)
unnamed: C107.2, P104.2
unnamed: C108.2, P104.4
unnamed: C109.2, P104.6
unnamed: C111.1, R115.1, R116.2, U103.2 (-)
unnamed: C112.1, R117.2, R118.1, U104.2 (-)
unnamed: C112.2, R117.1, R119.2, U104.6
unnamed: C118.1, C119.1, C120.1, C121.1, C122.1, C123.1, C124.1, C125.1, C126.1, C127.1, C128.1, C129.1, C130.1, C131.1, C132.1, C133.1, C134.1, C135.1, R107.2
unnamed: C118.2, C119.2, C120.2, C121.2, C122.2, C123.2, C124.2, C125.2, C126.2, C127.2, C128.2, C129.2, C130.2, C131.2, P108.2
unnamed: C132.2, C133.2, P108.4
unnamed: C134.2, P108.6
unnamed: C135.2, P108.8
unnamed: P105.1 (In), P107.1 (In), R119.1
unnamed: P106.1, R102.2, R103.2
unnamed: P106.3, R104.2
unnamed: P106.5, R120.2
unnamed: P106.7, R121.2
OUT: C102.2, R106.2, R109.2, U101.2 (-)

Notes on the sheet:
R PSD NF G20 G40 G60 G80 short 0 60R 1 nV/sqrt(Hz) -180 dBV 600R 3.2 nV/sqrt(Hz) -170 dBV 6k 10 nV/sqrt(Hz) -160 dBV
+6 VDC
GAIN SELECT
AMP3 G_a3 = 20.08 dB
16x input stage G_in = 20.08 dB ADA4898 voltage noise 0.9 nV/sqrt(Hz) 16 op-amps in parallell -> 1/sqrt(N) = 0.25 ideal noise floor 0.225 nV/sqrt(Hz) = -193 dBV
10 Hz
LDOs
original design 4x47u = 188uF
Divider3 G_d3 = -0.83 dB
100 Hz
AMP2 G_a2 = 20.83 dB
1 Hz
G_20 = +20.08 (G_in) -0.83 (G_d3) +6.78 (G_out) -6.02 (G_load) G_20 = +20.01 dB
Input C 10 Hz: 1u + 0u47 = 1.47uF with 10kR gives 1 Hz 0.1 Hz: 16x10u = 160 uF with 10kR gives 0.1 Hz
20 pcs 10uF 50V X7R 1210
50R load G_load = -6.02 dB
SMA or BNC output
one amp 0.9nV/rt(Hz) 16 amps should give 225pV/rt(Hz) in theory
SMA or BNC input
Divider2 G_d2 = -0.83 dB
G_60 = +20.08 (G_in) +20.83 (G_sum) -0.83 (G_d1) +20.83 (G_a2) -0.83 (G_d2) -0.83 (G_d3) +6.78 (G_out) -6.02 (G_load) G_60 = +60.01 dB
-6 VDC
Divider1 G_d1 = -0.83 dB
Input noise-test GND: noise floor 60R 1nV/sqrt(Hz) = -180 dBV 600R 3nV/sqrt(HZ) = -170 dBV
G_40 = +20.08 (G_in) +20.83 (G_sum) -0.83 (G_d1) -0.83 (G_d3) +6.78 (G_out) -6.02 (G_load) G_40 = +40.01 dB
50 Ohm drive
Sum stage G_sum = 20.83 dB
0.1 Hz
AMP_OUT G_out = 6.78 dB
14 pcs 10 uF = 140 uF
HI-BW SELECT 1.2 MHz 100 kHz 1 kHz
