aewallin/ADA4898_LNA/ADA4898_subunit.kicad_sch

## KiCad design ADA4898_subunit.kicad_sch (2025-11-16)

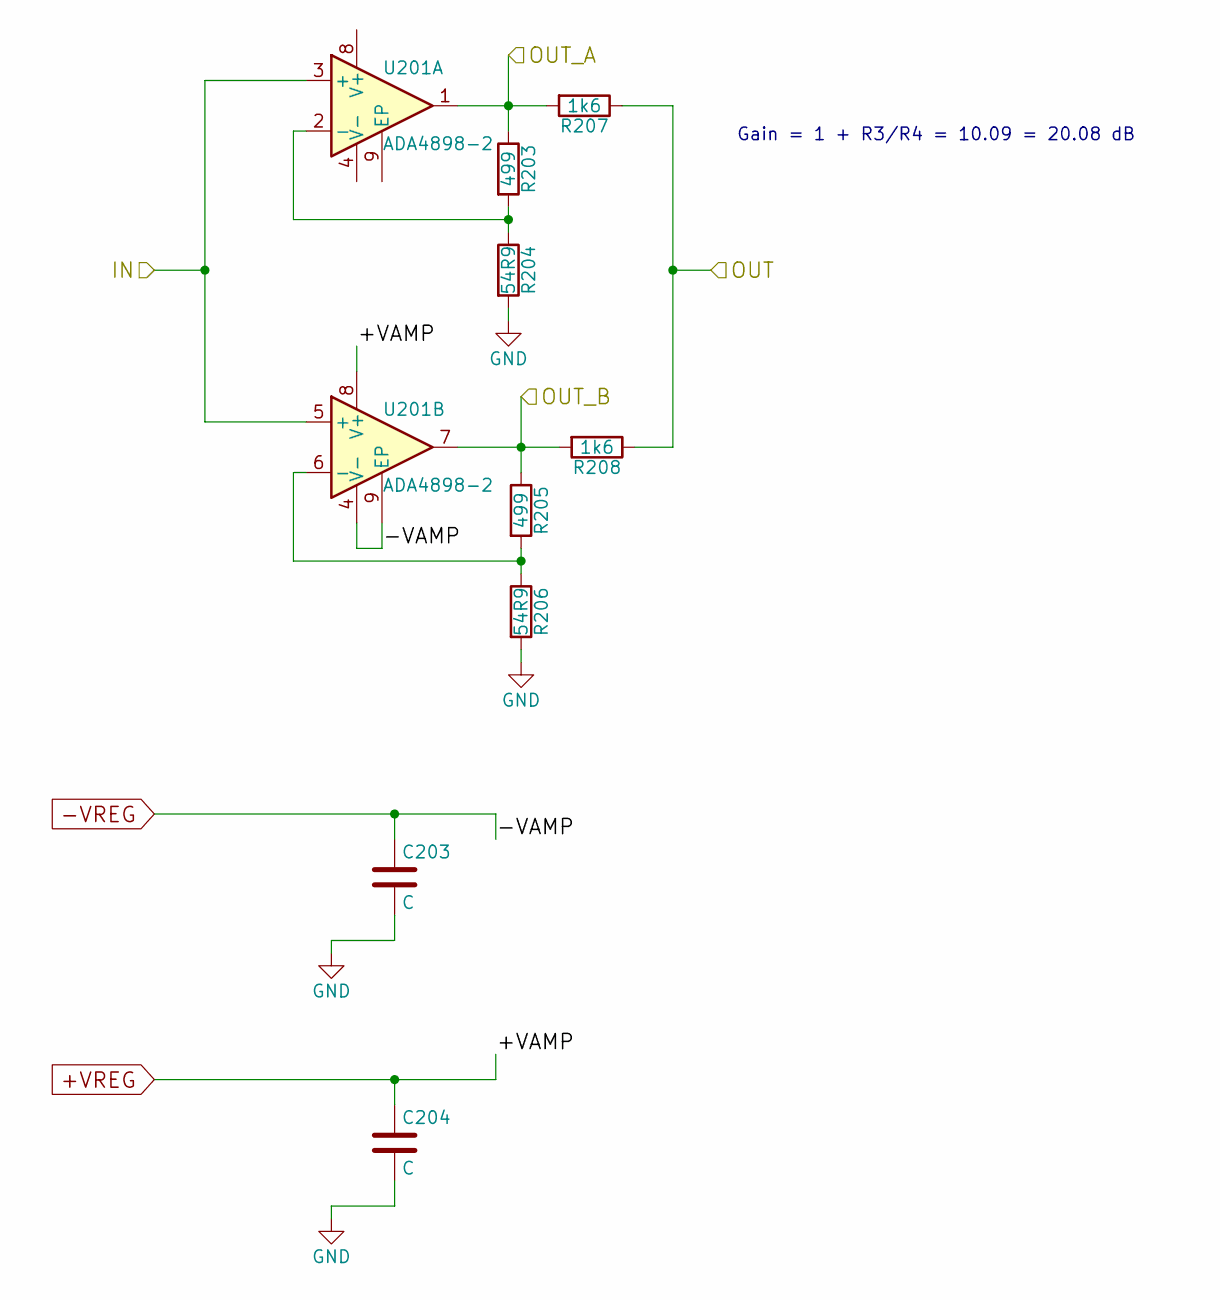
[picture p27: schematic ADA4898_subunit.kicad_sch]

Parts:
C203, C204: C; C_0805
R203, R205: 499; R_0603
R204, R206: 54R9; R_0603
R207, R208: 1k6; R_0603
U201: ADA4898-2; SOIC-8-1EP_3.9x4.9mm_Pitch1.27mm

Connections:
+VREG: C204.1, U201.8 (V+)
-VREG: C203.1, U201.4 (V-), U201.9 (EP)
GND: C203.2, C204.2, R204.2, R206.2
IN: U201.3 (+), U201.5 (+)
unnamed: R203.2, R204.1, U201.2 (-)
unnamed: R205.2, R206.1, U201.6 (-)
OUT: R207.1, R208.1
OUT_A: R203.1, R207.2, U201.1
OUT_B: R205.1, R208.2, U201.7

Notes on the sheet:
Gain = 1 + R3/R4 = 10.09 = 20.08 dB
