aewallin/ADA4898_LNA/LNA_PSU.kicad_sch

## KiCad design LNA_PSU.kicad_sch (2025-11-16)

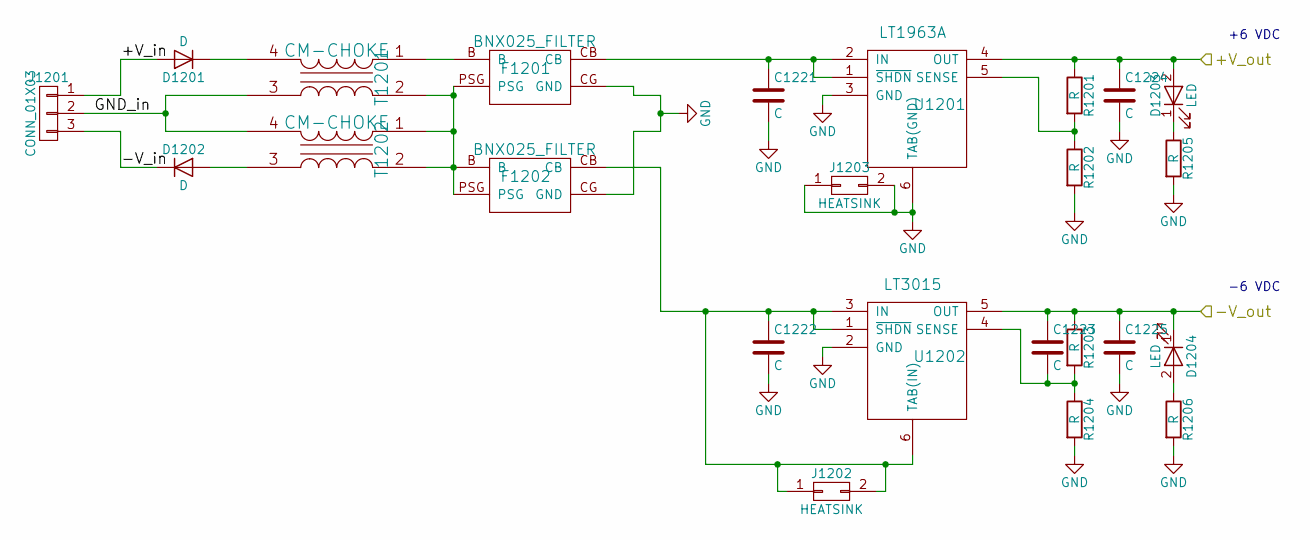
[picture p28: schematic LNA_PSU.kicad_sch]

Parts:
C1221, C1222, C1223, C1224, C1225: C; C_0805
D1201, D1202: D; DIODE_DO-214BA
D1203, D1204: LED; D_0805
F1201, F1202: BNX025_FILTER; FILTER_BNX025
J1201: CONN_01X03; CONNECTOR_01x03_200mil
J1202, J1203: HEATSINK; Heatsink_Fisher_TO263
R1201, R1202, R1203, R1204, R1205, R1206: R; R_0805
T1201, T1202: CM-CHOKE
U1201: LT1963A; TO-263-5_TabPin3
U1202: LT3015; TO-263-5_TabPin3

Connections:
+V_in: D1201.2 (A), J1201.1
+V_out: C1224.1, D1203.2 (A), R1201.1, U1201.4 (OUT)
-V_in: D1202.1 (K), J1201.3
-V_out: C1223.1, C1225.1, D1204.1 (K), R1203.1, U1202.5 (OUT)
GND: C1221.2, C1222.2, C1224.2, C1225.2, F1201.CG (GND), F1202.CG (GND), J1203.1, J1203.2, R1202.2, R1204.2, R1205.2, R1206.2, U1201.3 (GND), U1201.6 (TAB(GND)), U1202.2 (GND)
GND_in: J1201.2, T1201.3 (SA), T1202.4 (AB)
unnamed: C1221.1, F1201.CB, U1201.1 (~SHDN), U1201.2 (IN)
unnamed: C1222.1, F1202.CB, J1202.1, J1202.2, U1202.1 (~SHDN), U1202.3 (IN), U1202.6 (TAB(IN))
unnamed: C1223.2, R1203.2, R1204.1, U1202.4 (SENSE)
unnamed: D1201.1 (K), T1201.4 (AB)
unnamed: D1202.2 (A), T1202.3 (SA)
unnamed: D1203.1 (K), R1205.1
unnamed: D1204.2 (A), R1206.1
unnamed: F1201.B, T1201.1 (AA)
unnamed: F1201.PSG, F1202.B, F1202.PSG, T1201.2 (SB), T1202.1 (AA), T1202.2 (SB)
unnamed: R1201.2, R1202.1, U1201.5 (SENSE)

Notes on the sheet:
+6 VDC
-6 VDC
