aewallin/ADA4898_LNA/cap_array.kicad_sch

## KiCad design cap_array.kicad_sch (2025-11-16)

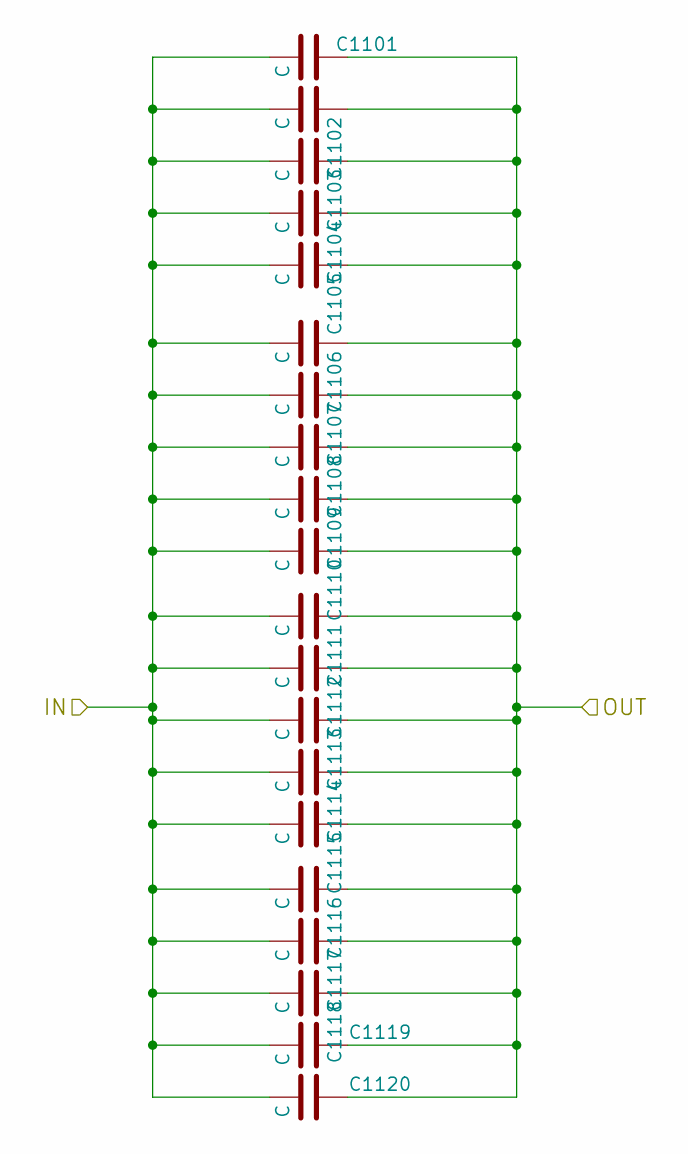
[picture p29: schematic cap_array.kicad_sch]

Parts:
C1101, C1102, C1103, C1104, C1105, C1106, C1107, C1108, C1109, C1110, C1111, C1112, C1113, C1114, C1115, C1116, C1117, C1118, C1119, C1120: C; C_1210

Connections:
IN: C1101.2, C1102.2, C1103.2, C1104.2, C1105.2, C1106.2, C1107.2, C1108.2, C1109.2, C1110.2, C1111.2, C1112.2, C1113.2, C1114.2, C1115.2, C1116.2, C1117.2, C1118.2, C1119.2, C1120.2
OUT: C1101.1, C1102.1, C1103.1, C1104.1, C1105.1, C1106.1, C1107.1, C1108.1, C1109.1, C1110.1, C1111.1, C1112.1, C1113.1, C1114.1, C1115.1, C1116.1, C1117.1, C1118.1, C1119.1, C1120.1
