aewallin/ADA4898_LNA/(commit log)

2022-11-09 initial commit of kicad6 migrated files
    [ADA4898_LNA.kicad_pcb, ADA4898_LNA.kicad_sch, ADA4898_subunit.kicad_sch, LNA_PSU.kicad_sch, cap_array.kicad_sch]
2022-11-09 pcb images from kicad
2022-11-10 add notes
    [ADA4898_LNA.kicad_sch, ADA4898_subunit.kicad_sch, LNA_PSU.kicad_sch]
